Macnica-Galaxy/Document/Base board Schematic_C.pdf

# BASE BOARD_1

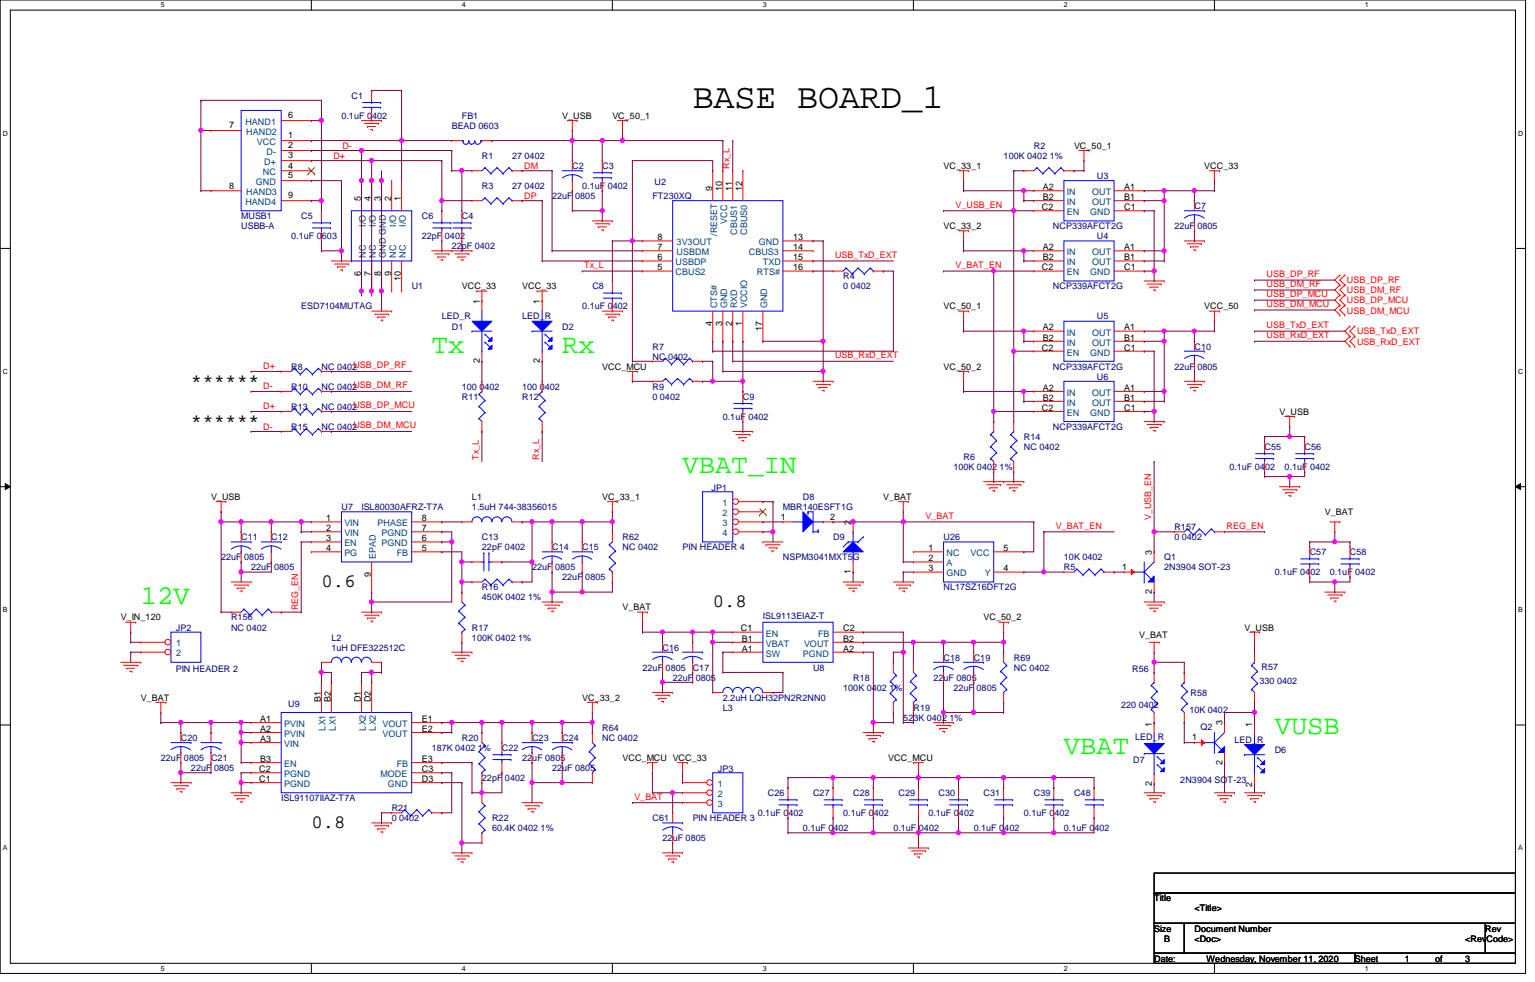
[picture p8: page 1]

# BASE BOARD_5

# SENSOR1

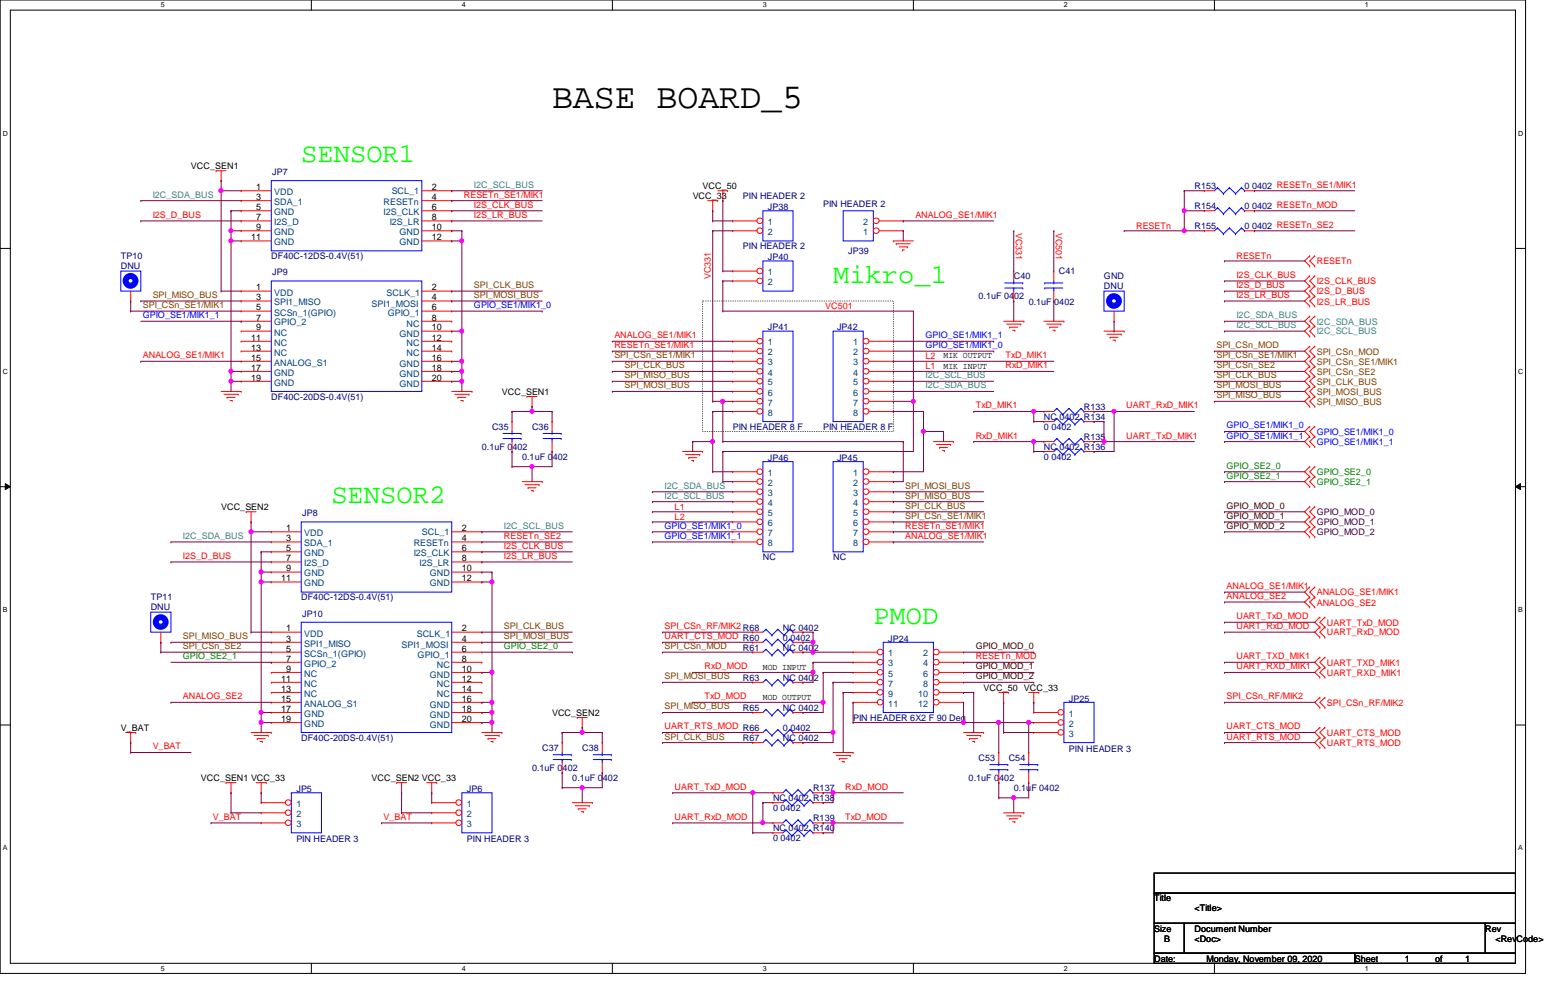
[picture p9: page 2]

# Mikro_2

# BASE BOARD_3

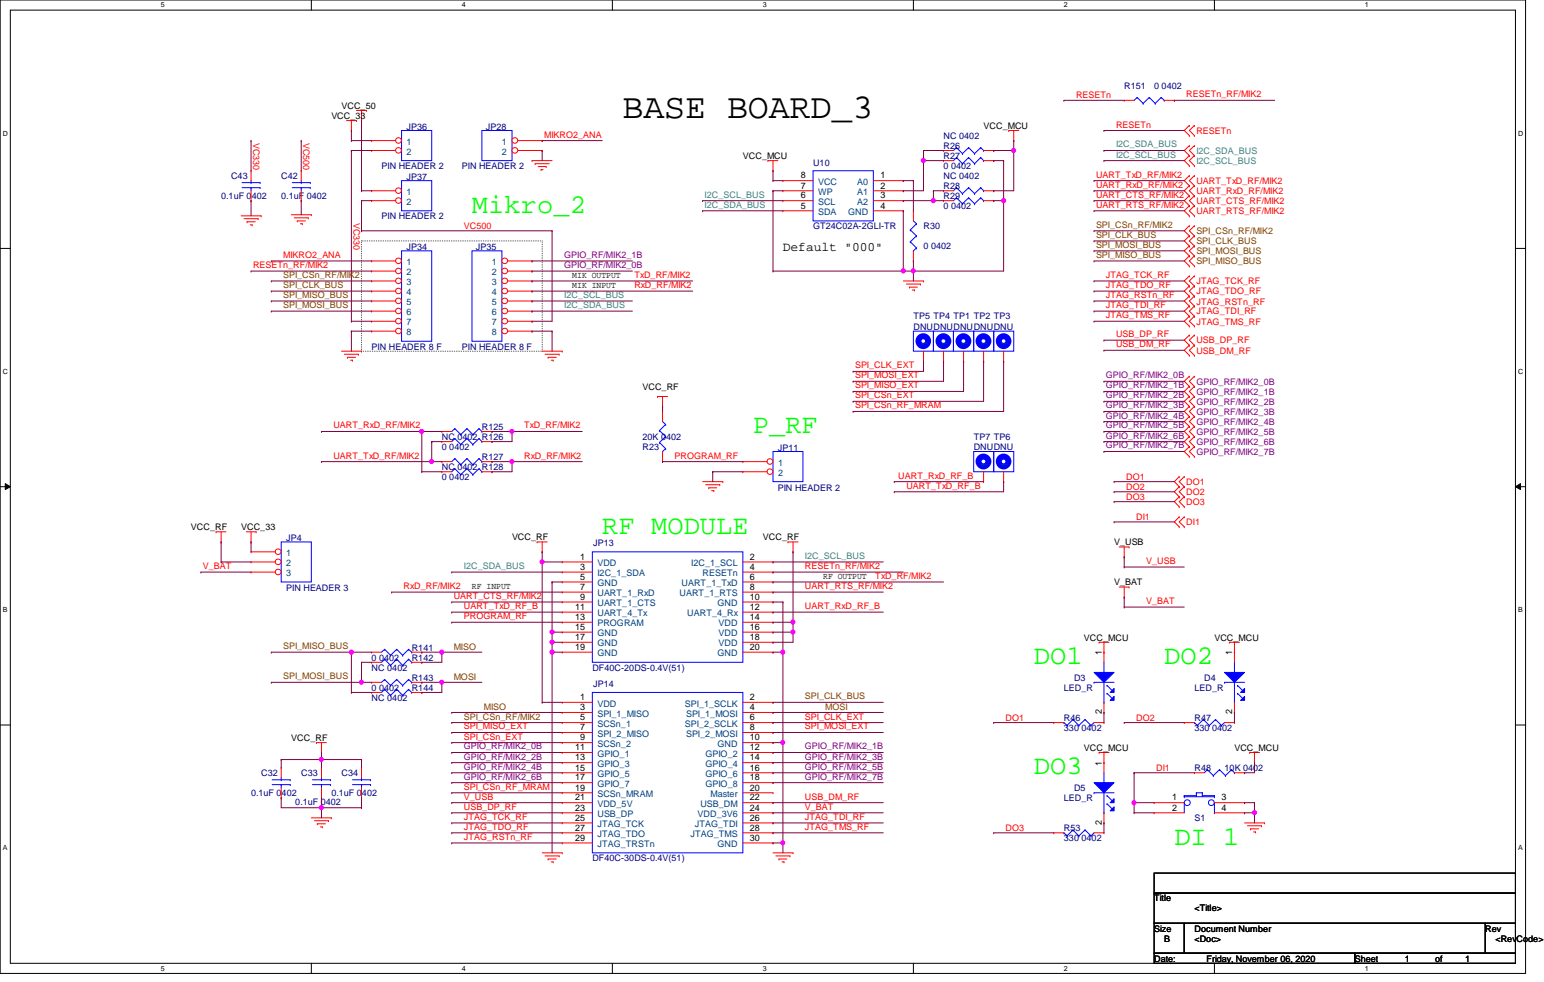
[picture p10: page 3]

GND 4 SDA 5 SCL 6 WP 7 VCC 8

# BASE BOARD_6

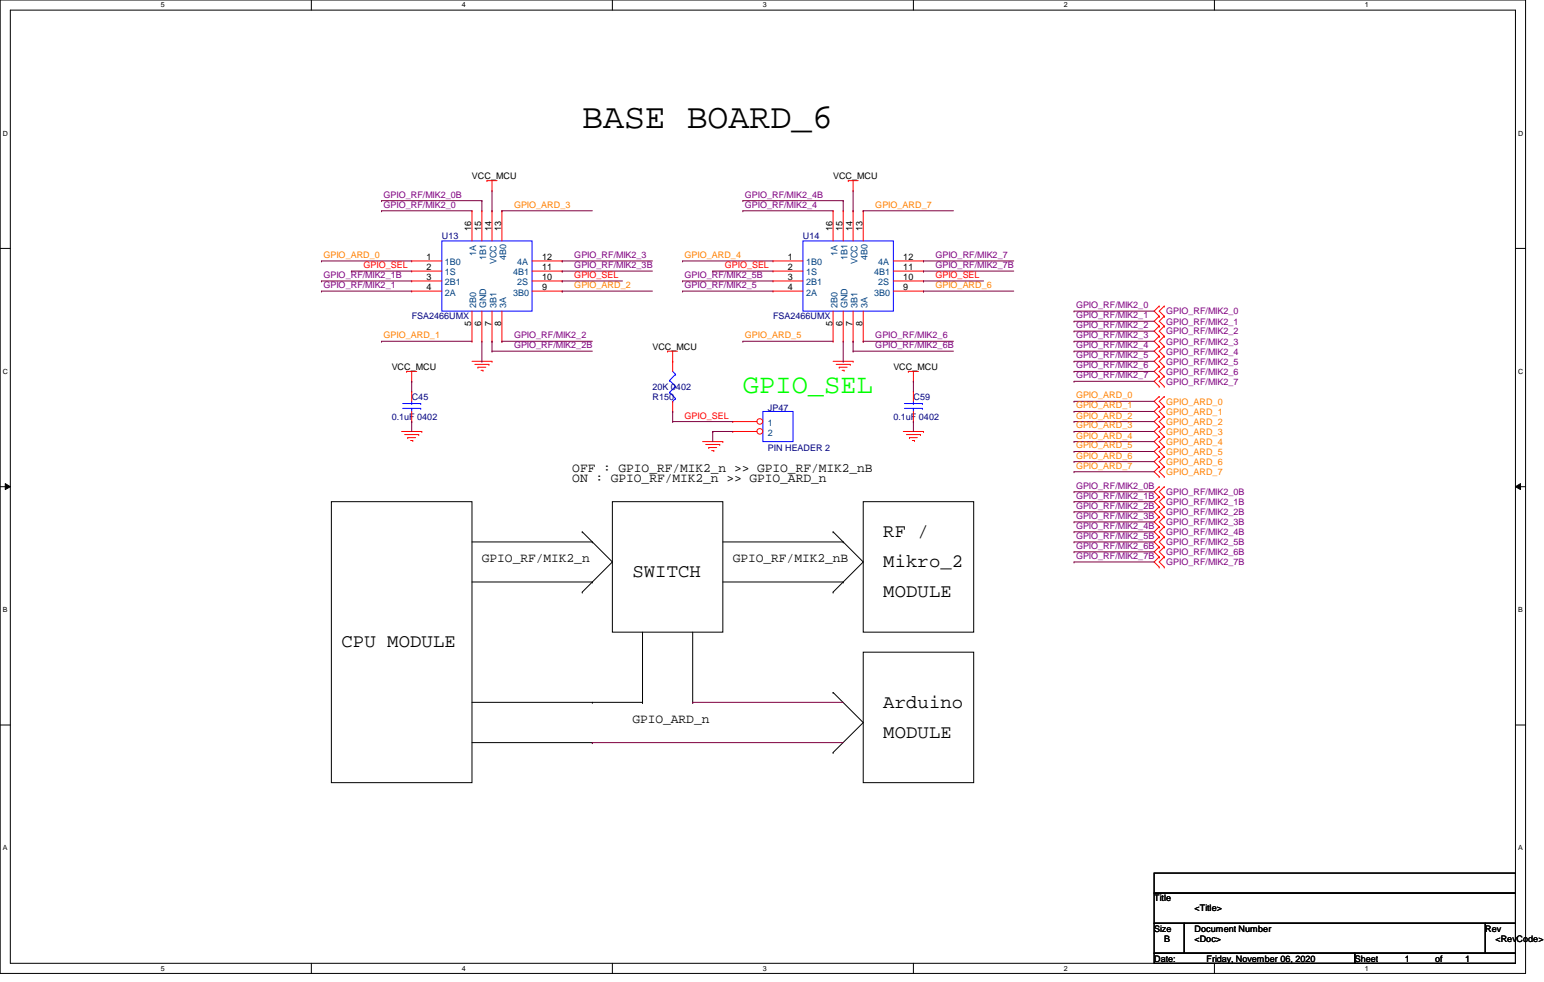
[picture p11: page 4]
CPU MODULE; SWITCH; GPIO_RF/MIK2_n; GPIO_ARD_n; GPIO_RF/MIK2_nB; Mikro_2; MODULE; Arduino MODULE; GPIO_SEL; OFF : GPIO_RF/MIK2_n >> GPIO_RF/MIK2_nB ON : GPIO_RF/MIK2_n >> GPIO_ARD_n; VCC_MCU; GPIO_RF/MIK2_0 GPIO_RF/MIK2_1 GPIO_RF/MIK2_2 GPIO_RF/MIK2_3 GPIO_RF/MIK2_4 GPIO_RF/MIK2_5 GPIO_RF/MIK2_6 GPIO_RF/MIK2_7; GPIO_ARD_0 GPIO_ARD_1 GPIO_ARD_2 GPIO_ARD_3 GPIO_ARD_4 GPIO_ARD_5 GPIO_ARD_6 GPIO_ARD_7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

# BASE BOARD_2

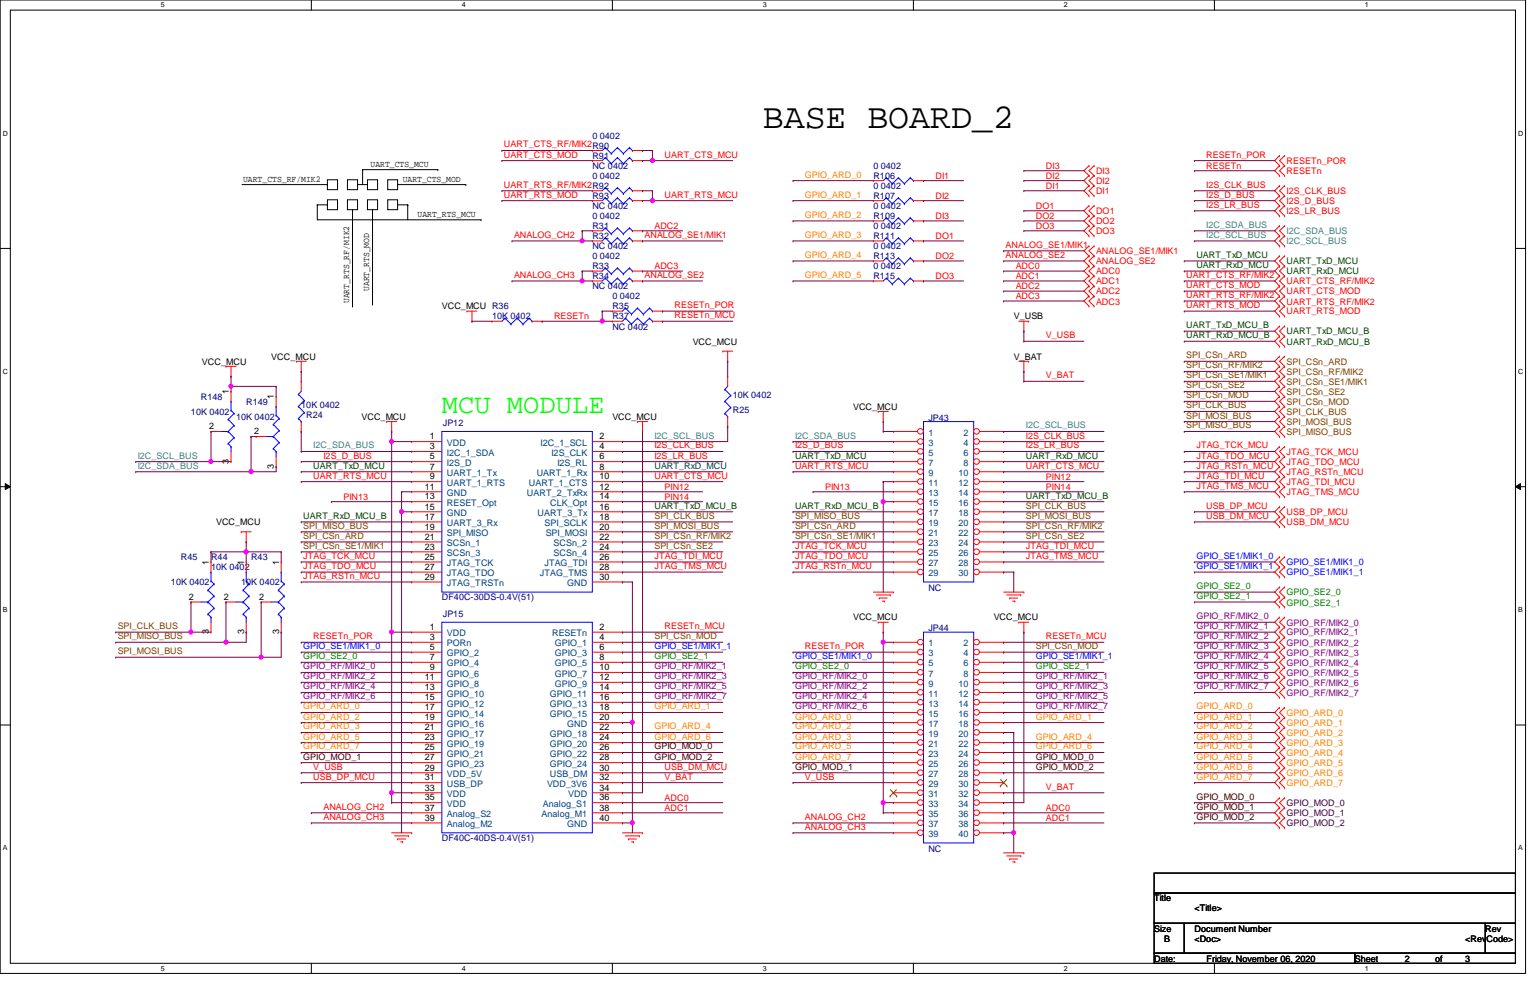
[picture p12: page 5]

# Arduino

# BASE BOARD_4

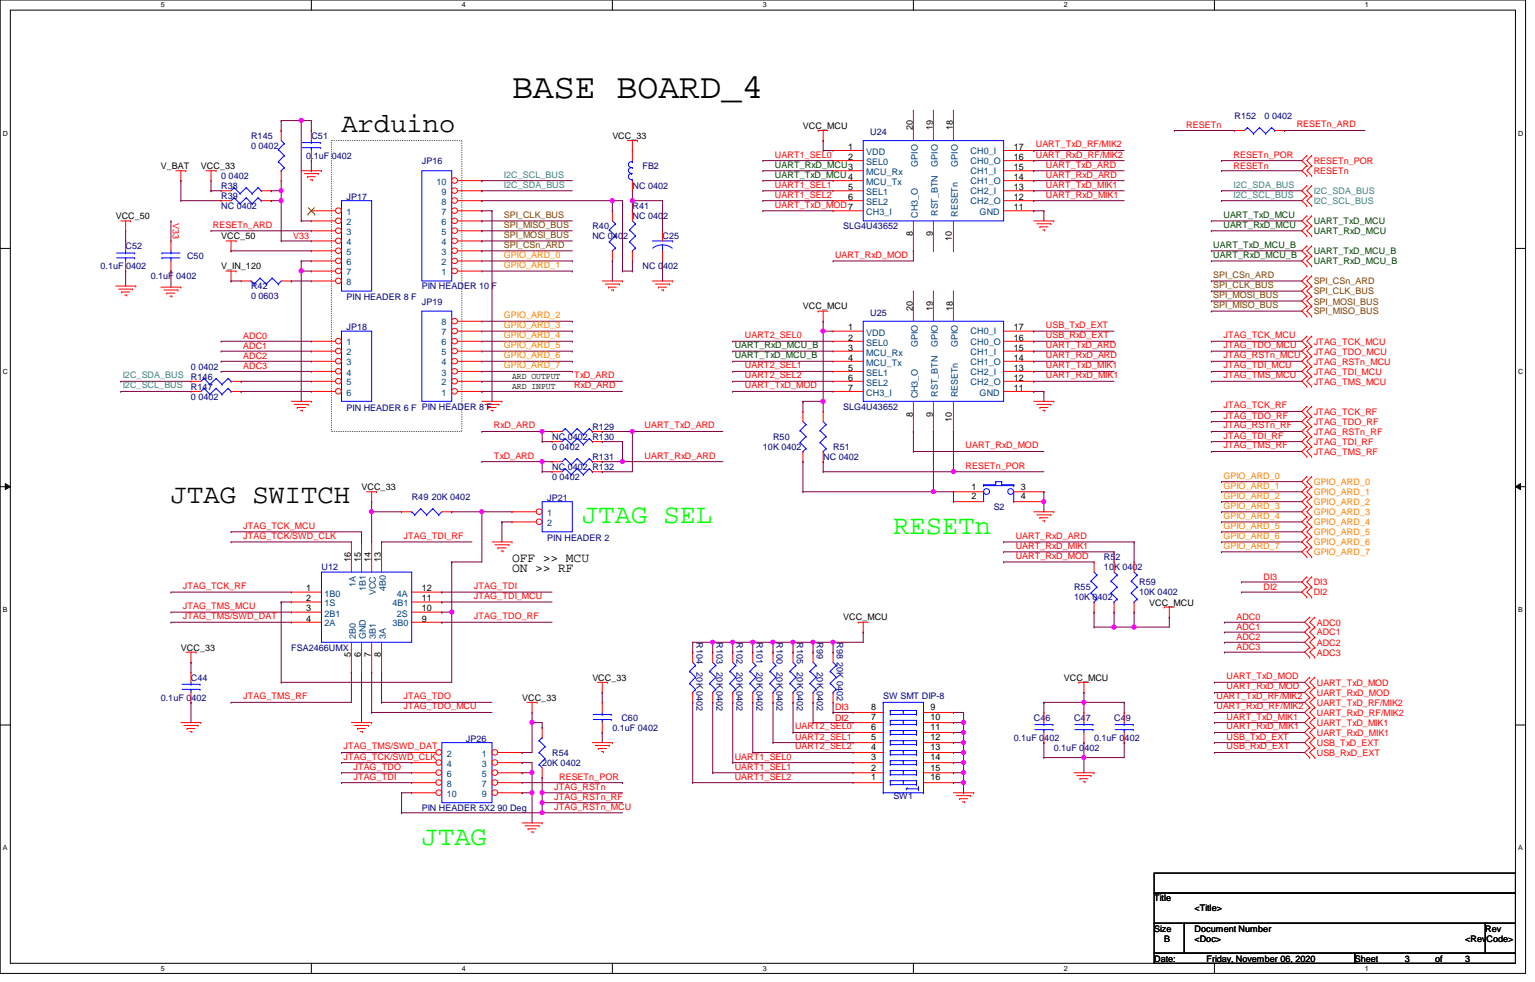
[picture p13: page 6]
