Macnica-Galaxy/Document/ON LV0104CS Sensor/49 ON LV0104CS Light Sensor.pdf

# ON Light Sensor

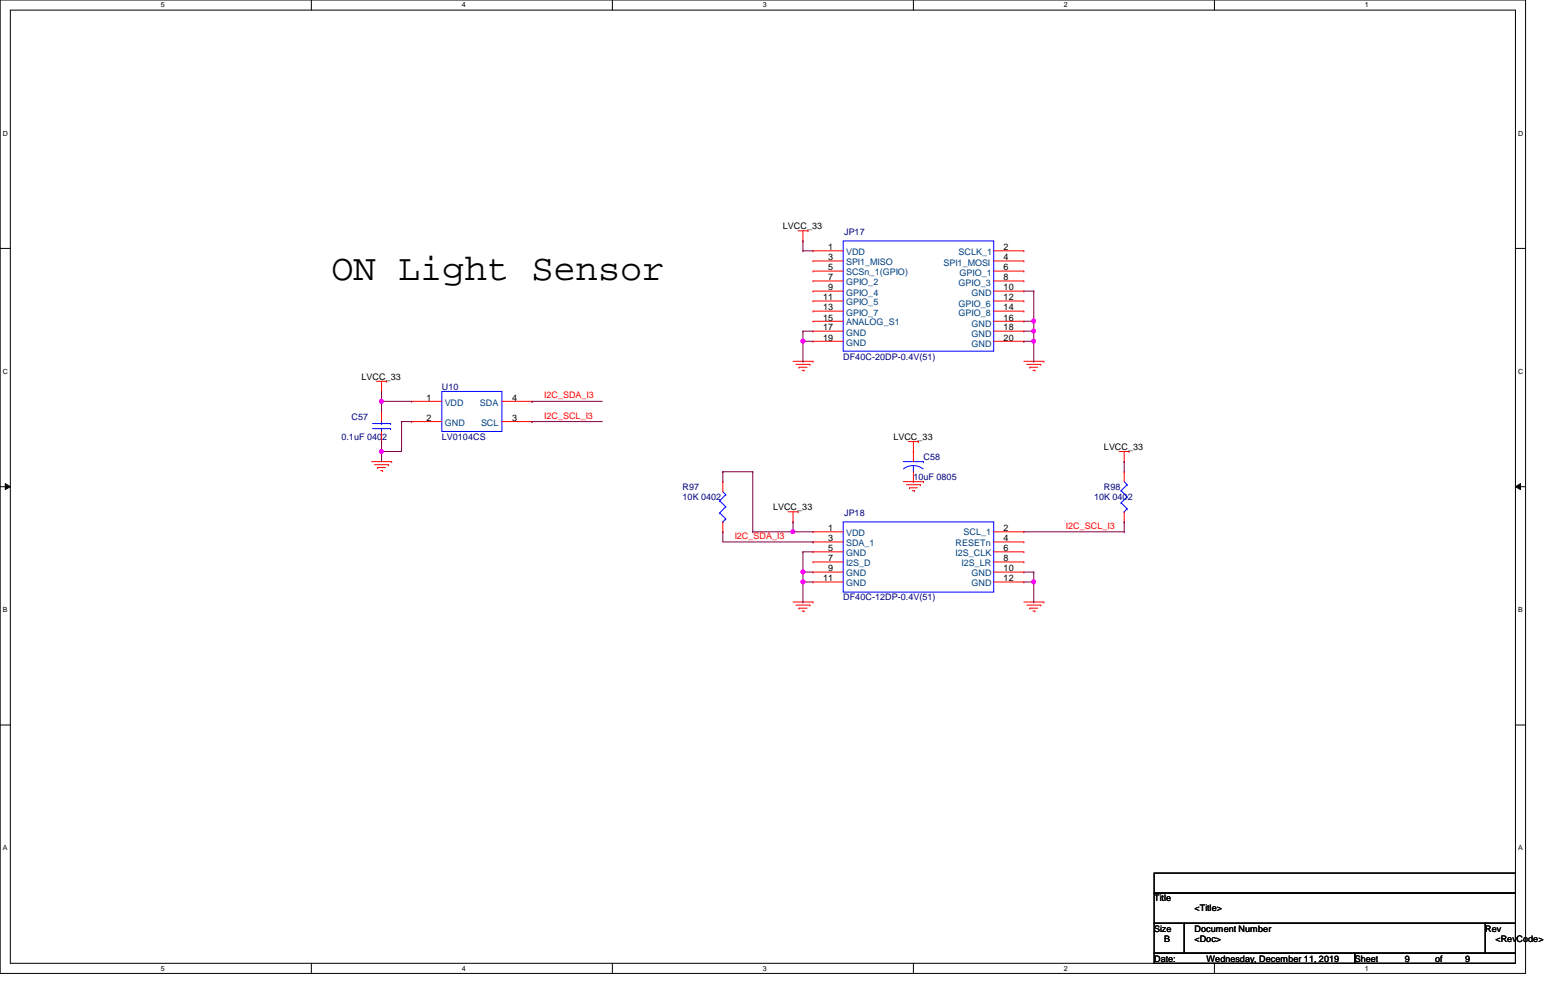
[picture p14: page 1]
LVCC_33; Title; Size; Document Number; Rev; Date:; Sheet; <Doc>; <RevCode>; <Title>; Wednesday, December 11, 2019; VDD 1; GND 2; SCL; SDA; RESETn; GND 5; I2S_CLK 6; GND 9; GND 10; GND 11; GND 12; SDA_1 3; SCL_1 2 VDD 1; SCSn_1(GPIO) 5; ANALOG_S1 15 GND 17; GND 19; GND 20; SCLK_1 2; SPI1_MISO 3; GPIO_7 13; SPI1_MOSI; GPIO_4 9; GPIO_3; 8 GPIO_2 7; GPIO_1 6; GPIO_6; 12 GPIO_5 11; GPIO_8; GND 16 GND 18; I2C_SCL_I3; I2C_SDA_I3
