Macnica-Galaxy/Document/Infineon DPS365 Sensor/43 Infineon Pressure Tempture.pdf

# Infineon Pressure & Tempture Sensor

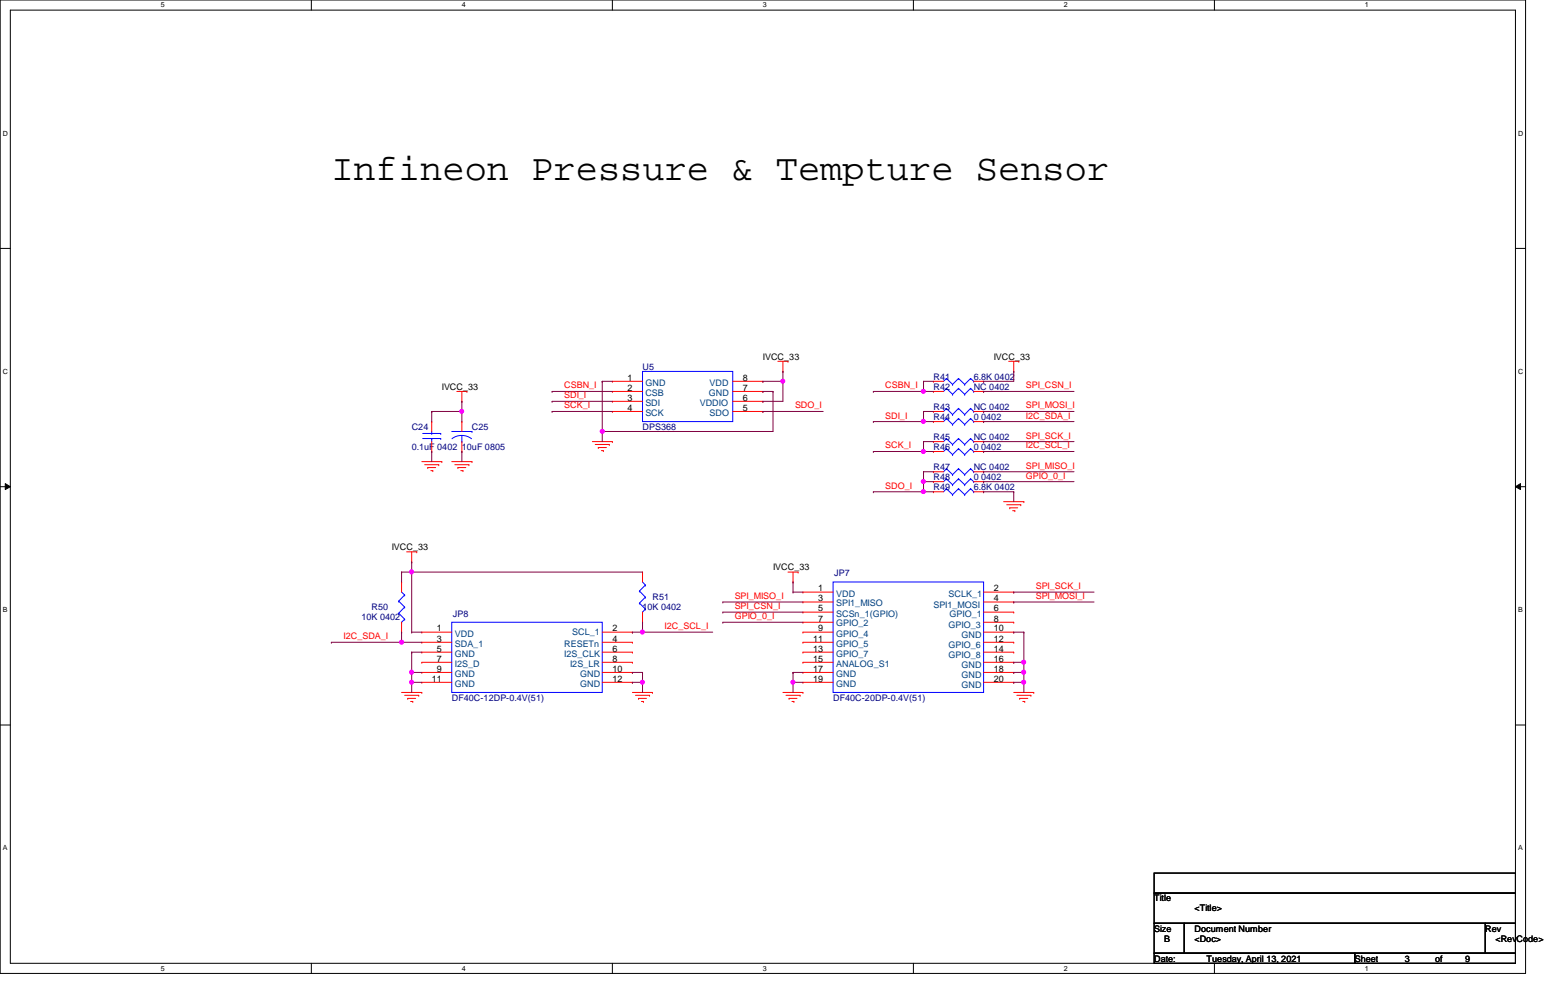
[picture p15: page 1]
