Macnica-Galaxy/Document/IDT HS3001 Sensor/31 IDT_HS300x_SENSOR.pdf

# IDT Humidity and Temperature Sensor

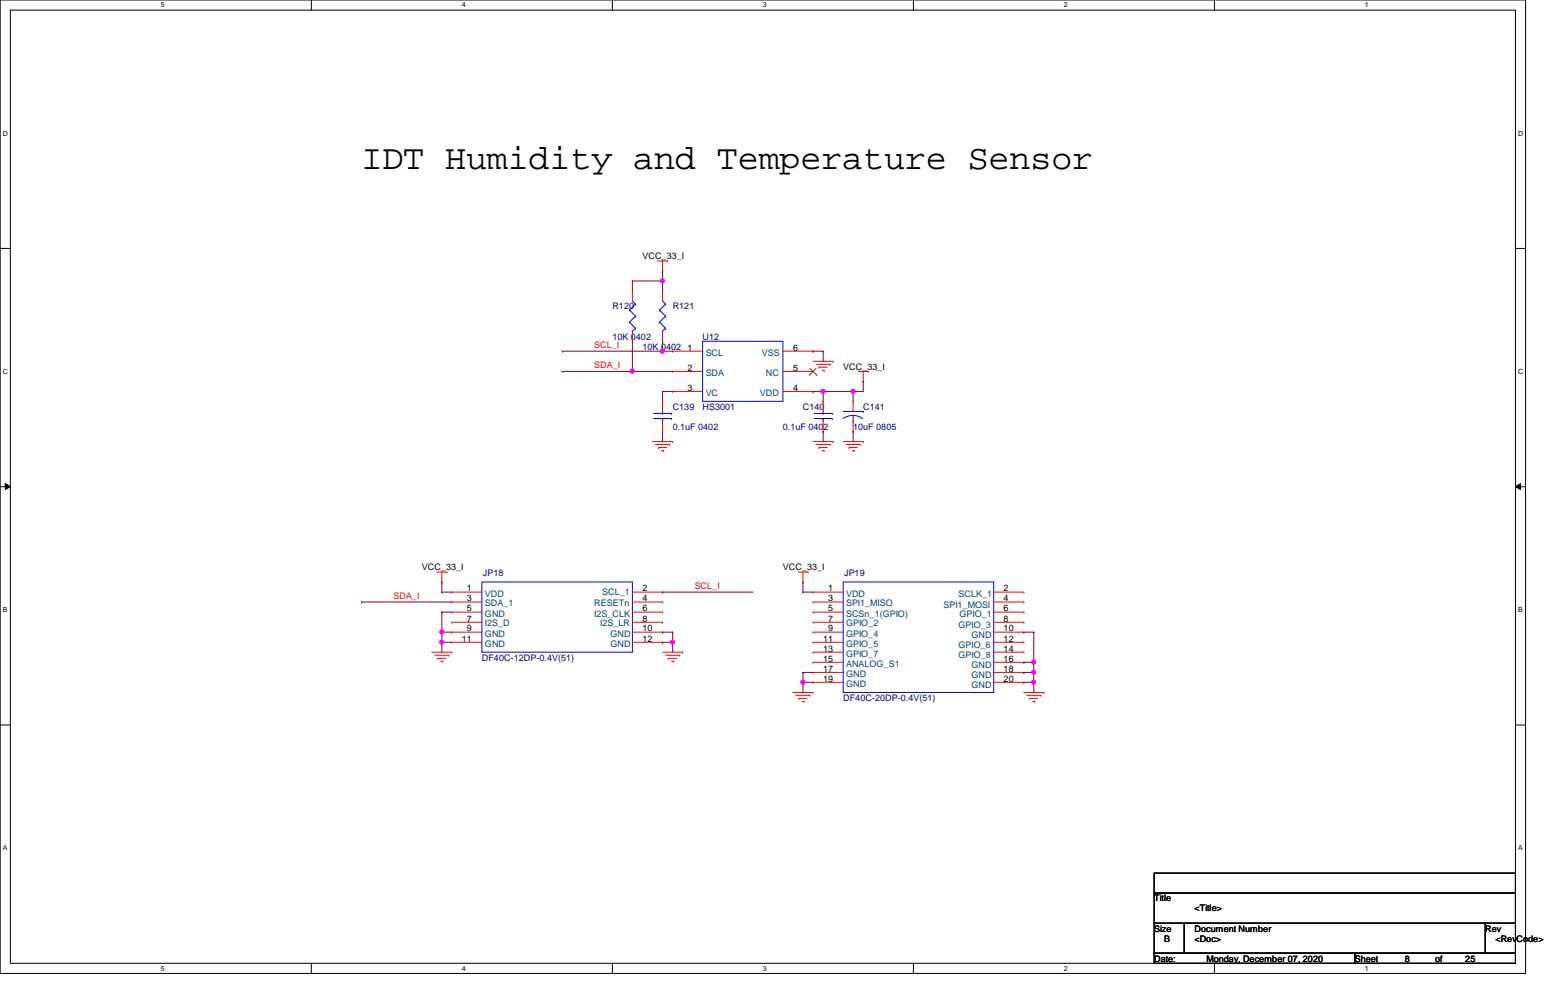
[picture p16: page 1]
