Macnica-Galaxy/Document/IDT ZMOD4401 Sensor/32 IDT_ZMOD4410_SENSOR.pdf

# IDT Gas Sensor

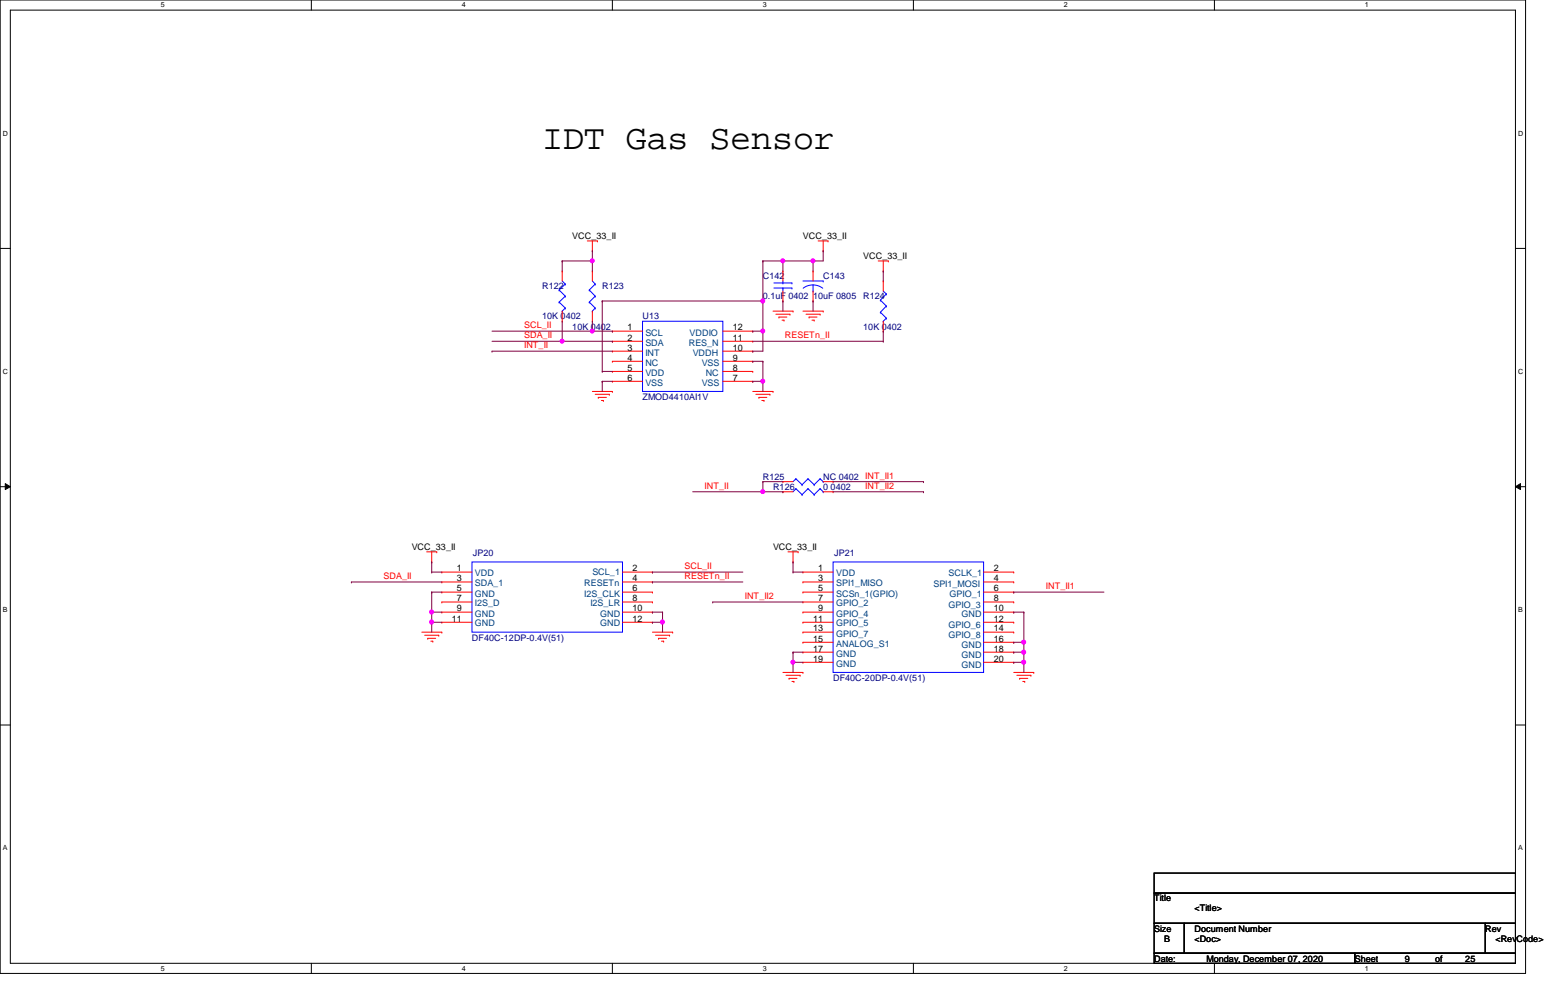
[picture p17: page 1]
