Macnica-Galaxy/Document/Microchip WIFI 1510 RF/26 Microchip_WIFI_1510.pdf

# MICROCHIP WIFI

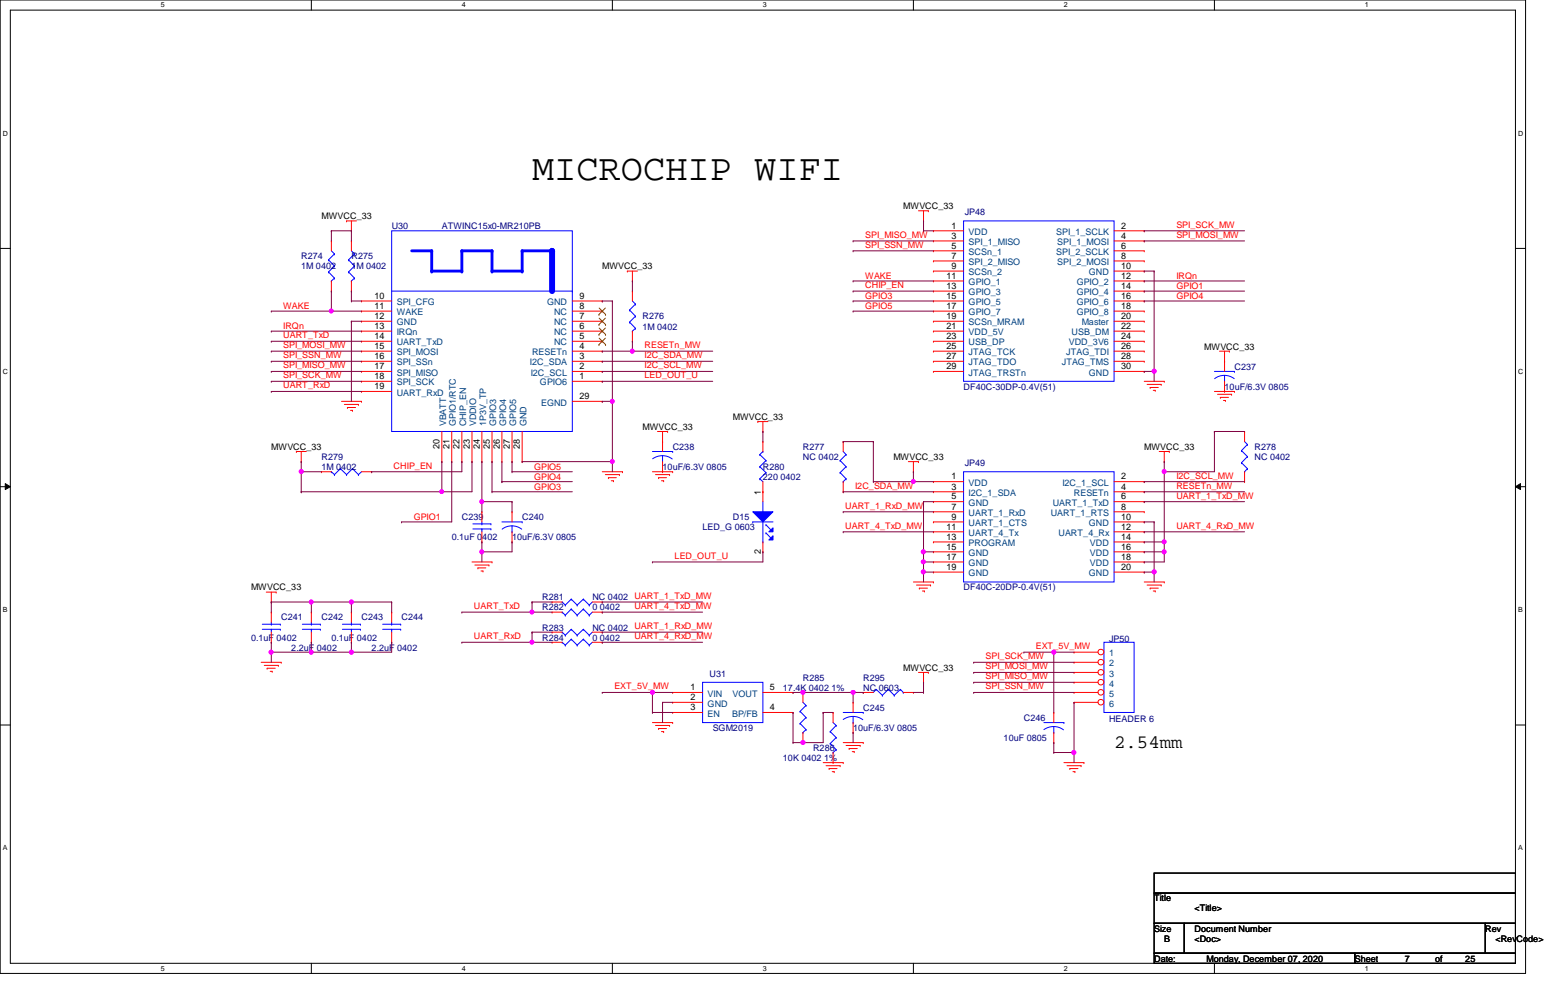
[picture p18: page 1]

GPIO6 1 I2C_SCL 2 I2C_SDA 3 RESETn 4 NC 5 NC 6 NC 7 NC 8 GND 9 SPI_CFG 10 WAKE 11 GND 12 IRQn 13 UART_TxD 14 SPI_MOSI 15 SPI_SSn 16 SPI_MISO 17 SPI_SCK 18
