Macnica-Galaxy/Document/ON NCT375 Sensor/33 ON_NCT375_SENSOR.pdf

# ON Semi Temperature Sensor

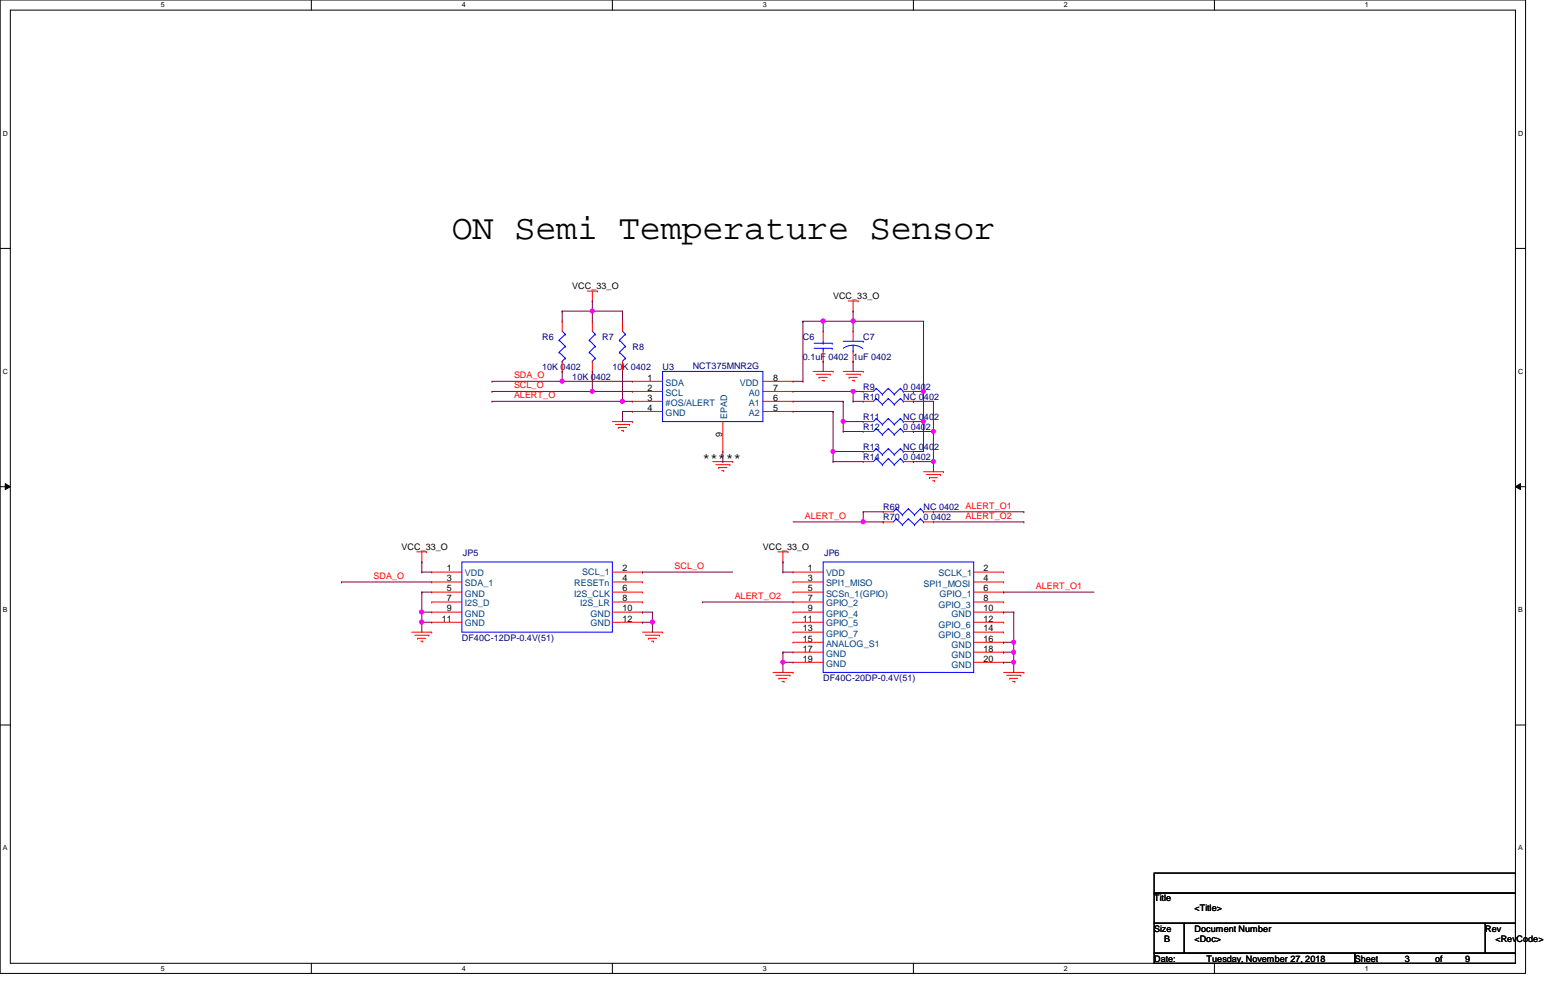
[picture p19: page 1]
