Macnica-Galaxy/Document/Renesas ISL29023 Sensor/49 Renesas ISL29023_SENSOR.pdf

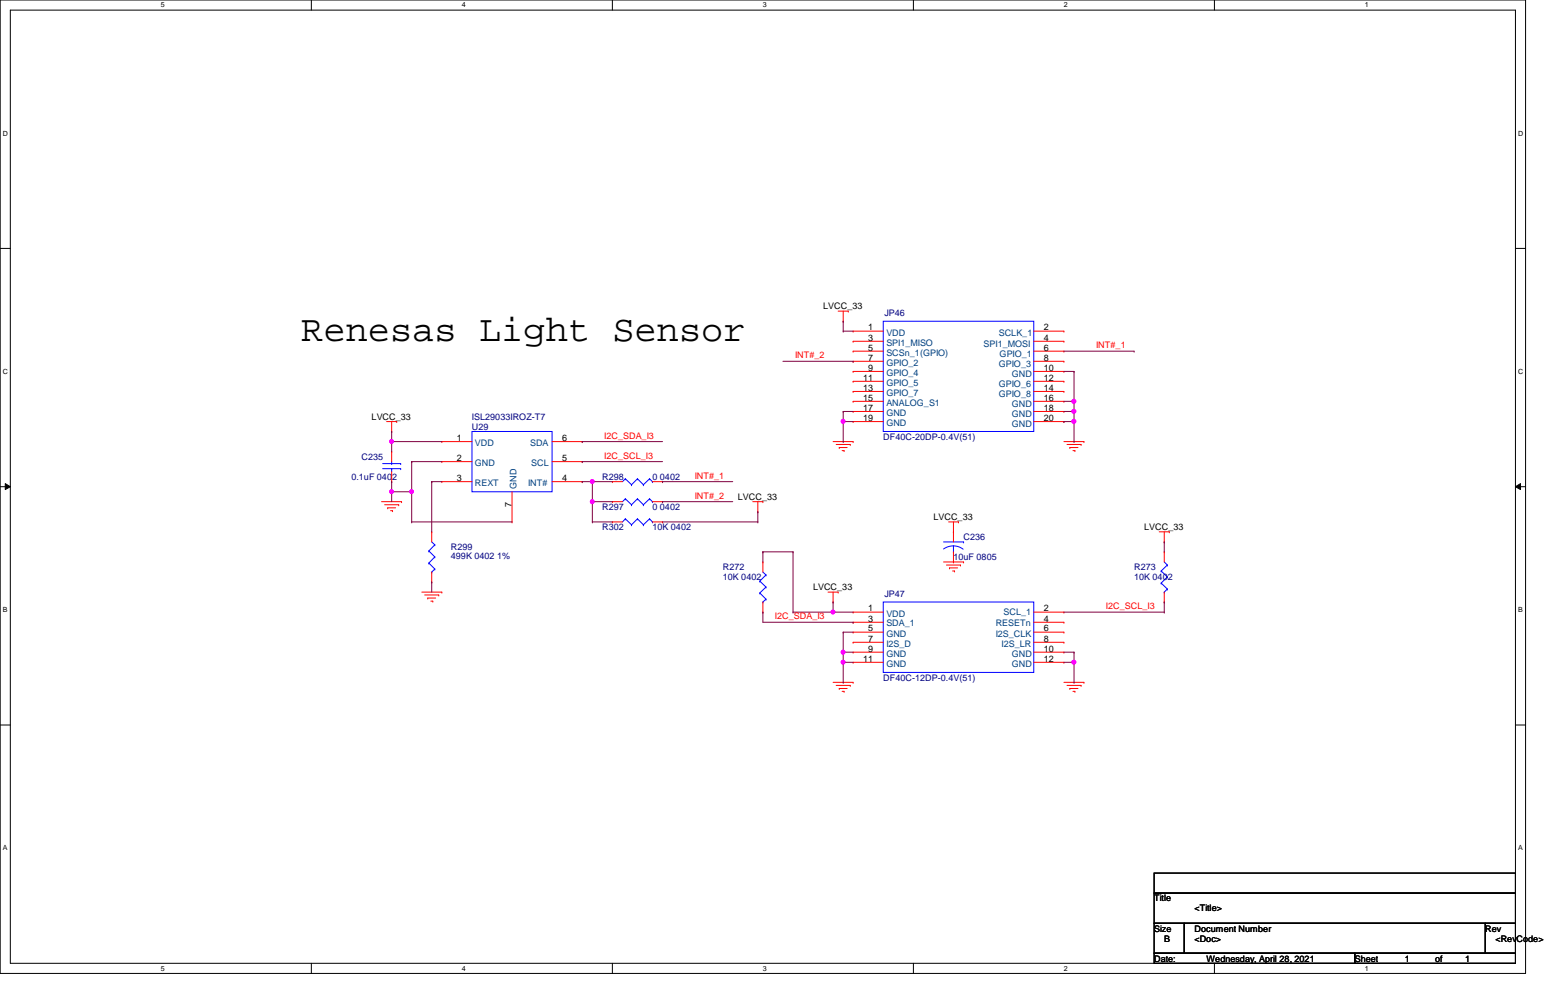
[picture p20: page 1]
