Macnica-Galaxy/Document/Microchip SAML21G18B MCU/21 Microchip_SAM21G18.pdf

## OUTPUT

# MICROCHIP

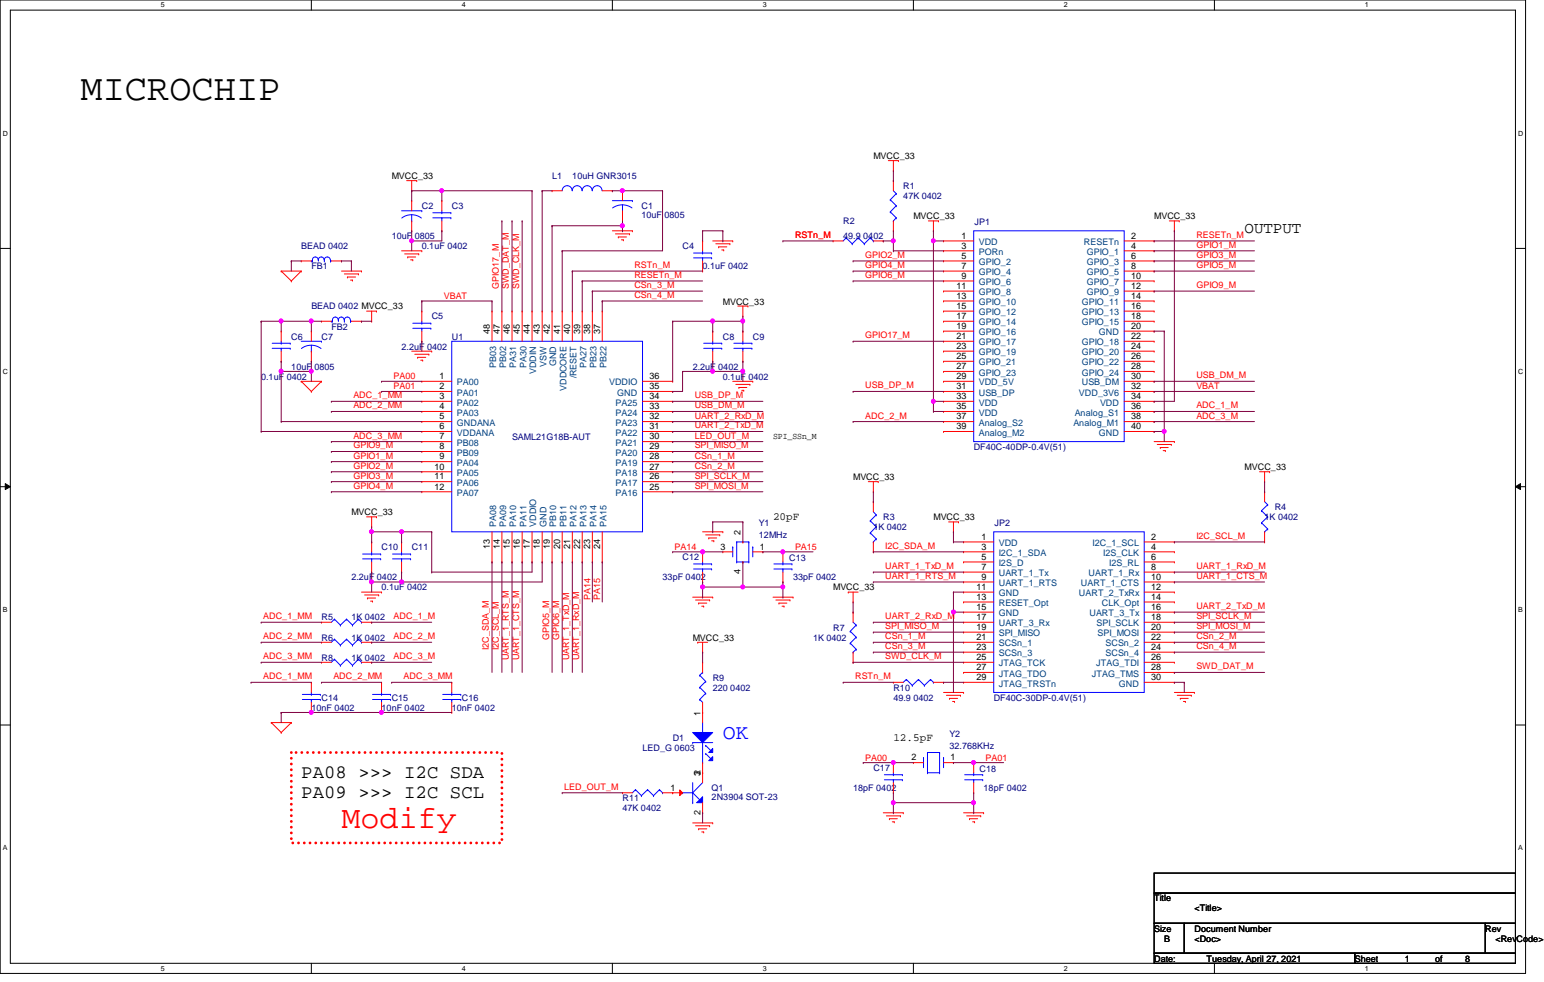
[picture p21: page 1]
