Macnica-Galaxy/Document/USI BM22 RF/41 USI_BM22_RF.pdf

# USI_BM22

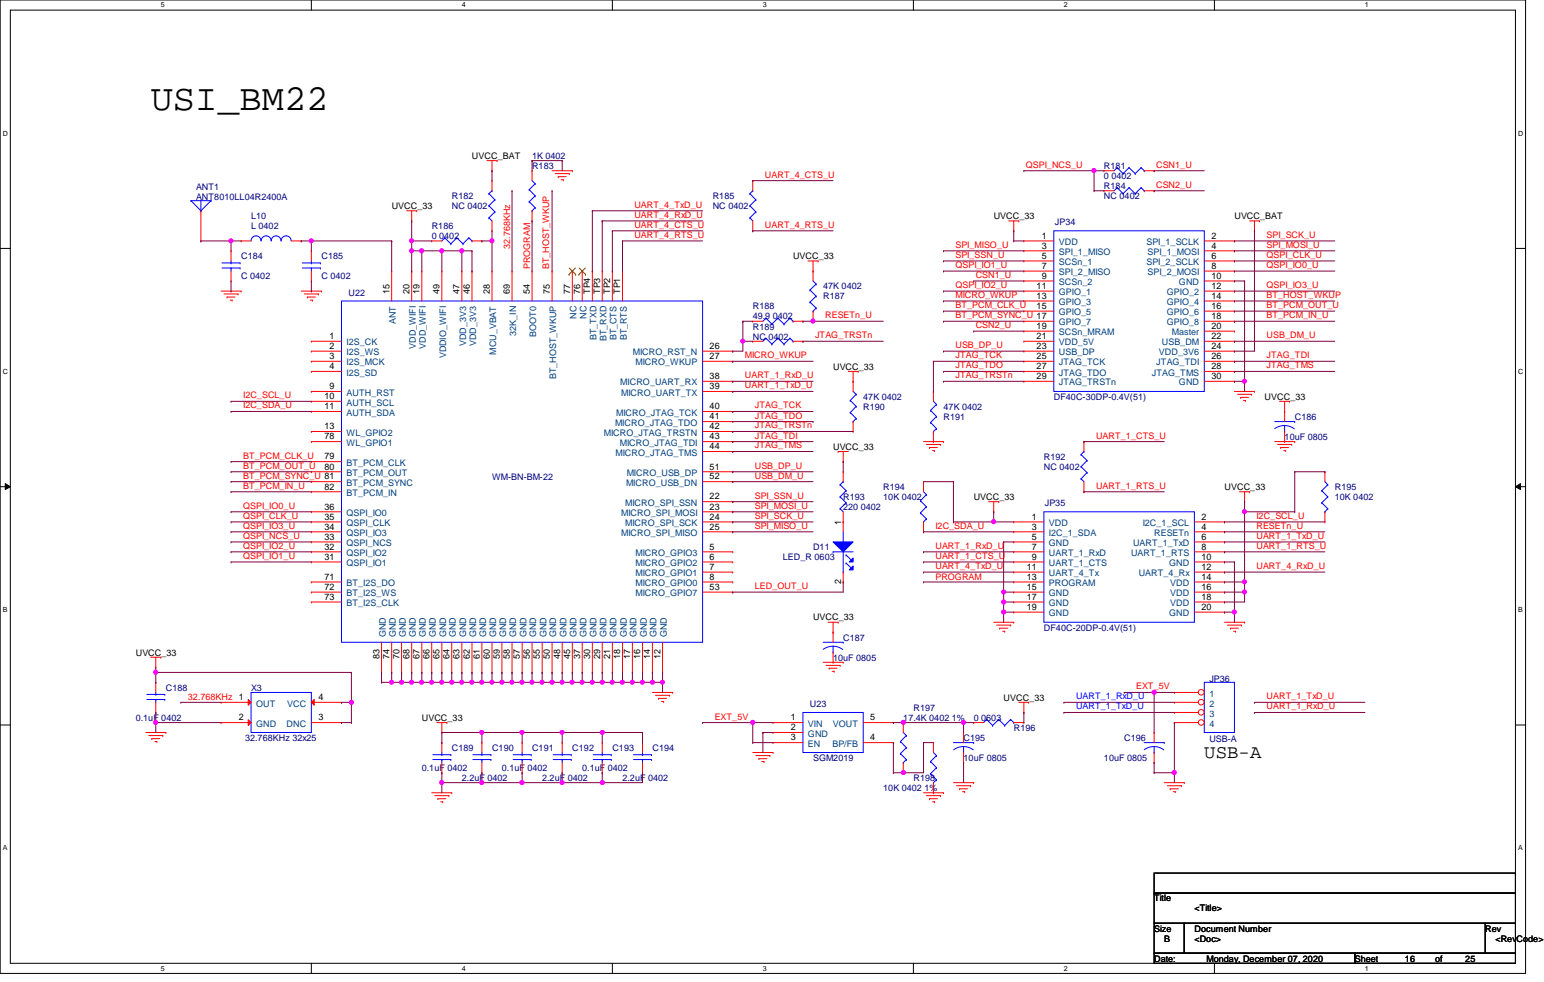
[picture p22: page 1]
