Macnica-Galaxy/Document/ADI ADXL362 Sensor/53 ADI ADXL362_SENSOR.pdf

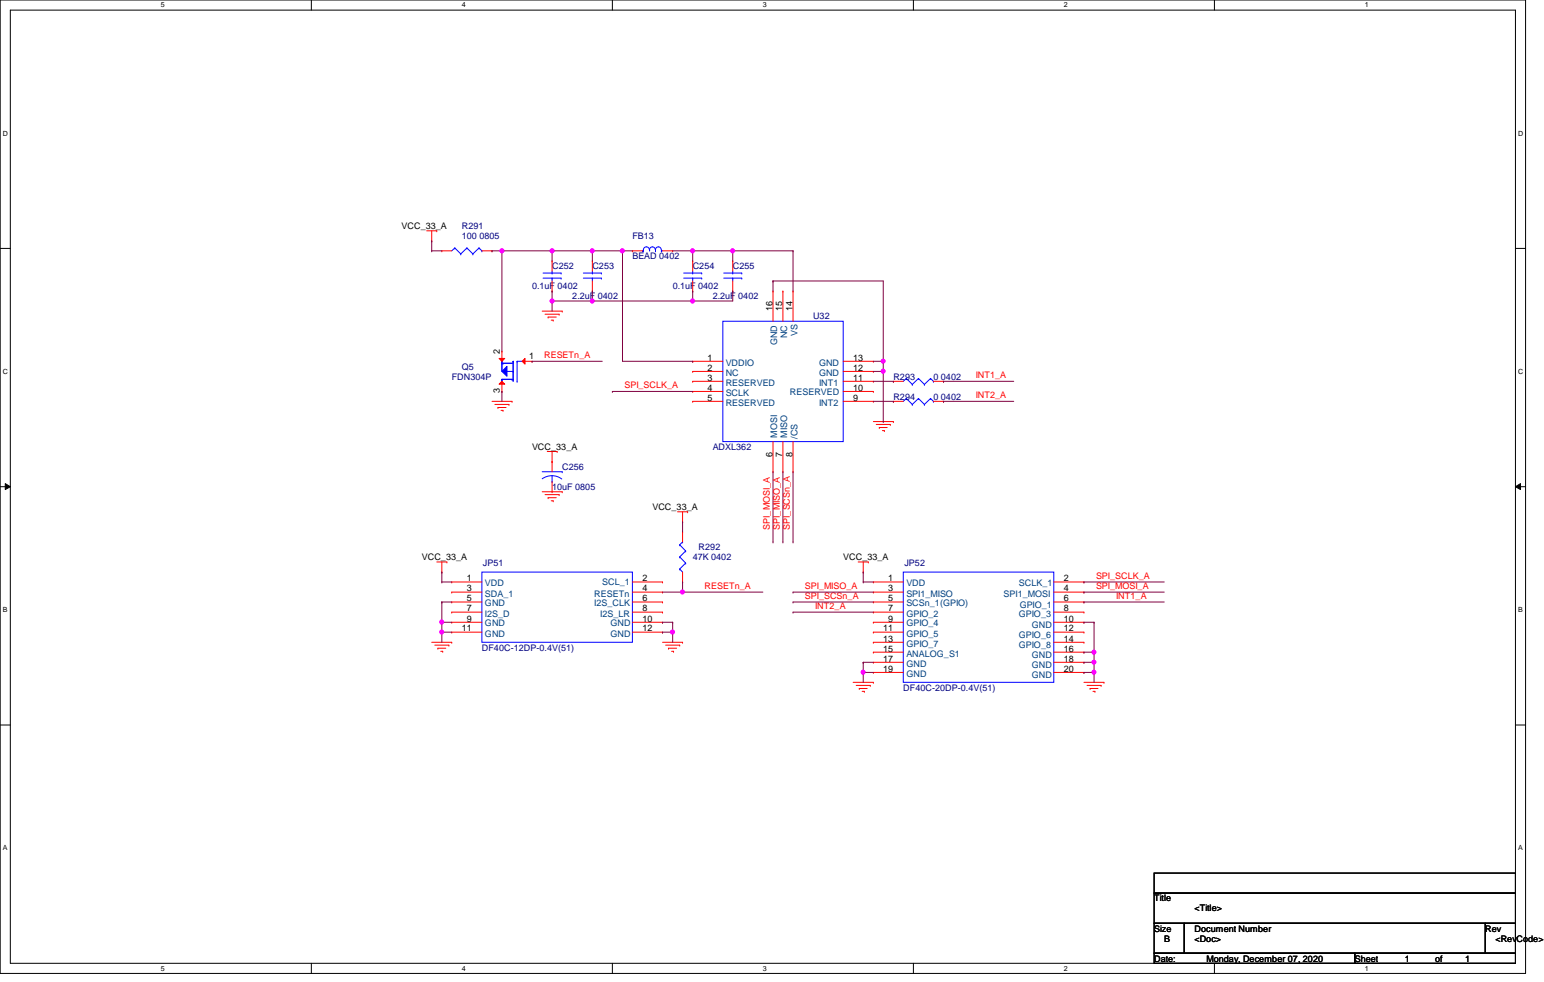
[picture p23: page 1]
