Macnica-Galaxy/Document/Cypress PSOC6 MCU/23 Cypress_BLE_MCU.pdf

*****

***** | *****

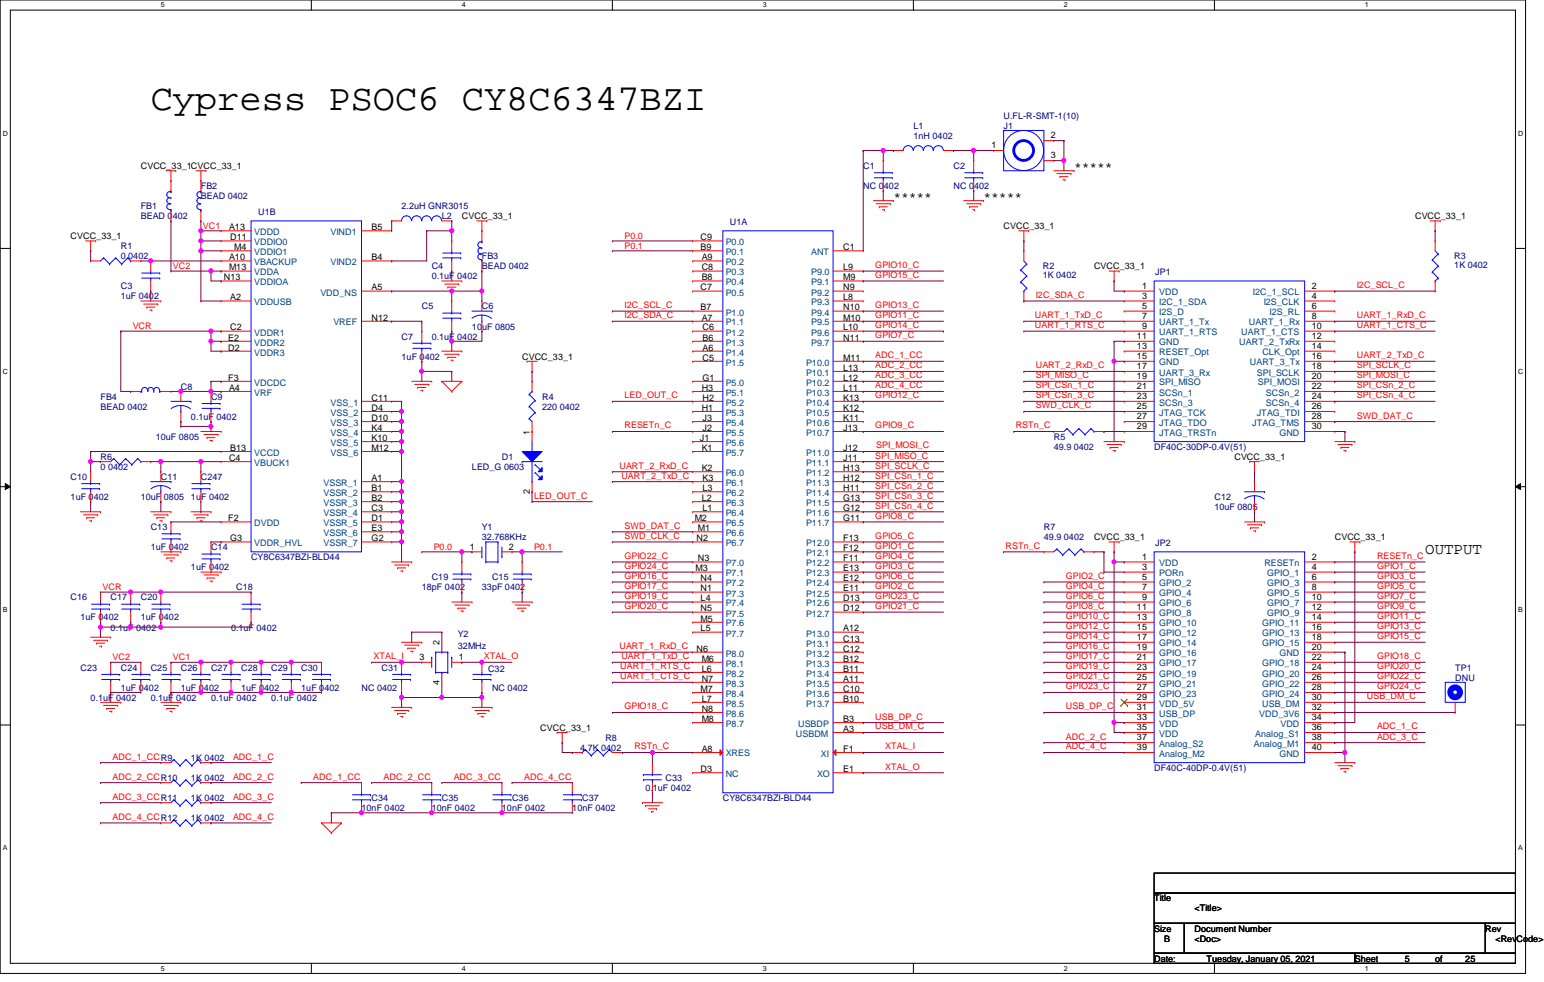
[picture p24: page 1]
