Macnica-Galaxy/Document/Dialog DA14531 RF/52 Dialog DA14531M.pdf

# Dialog DA14531MOD

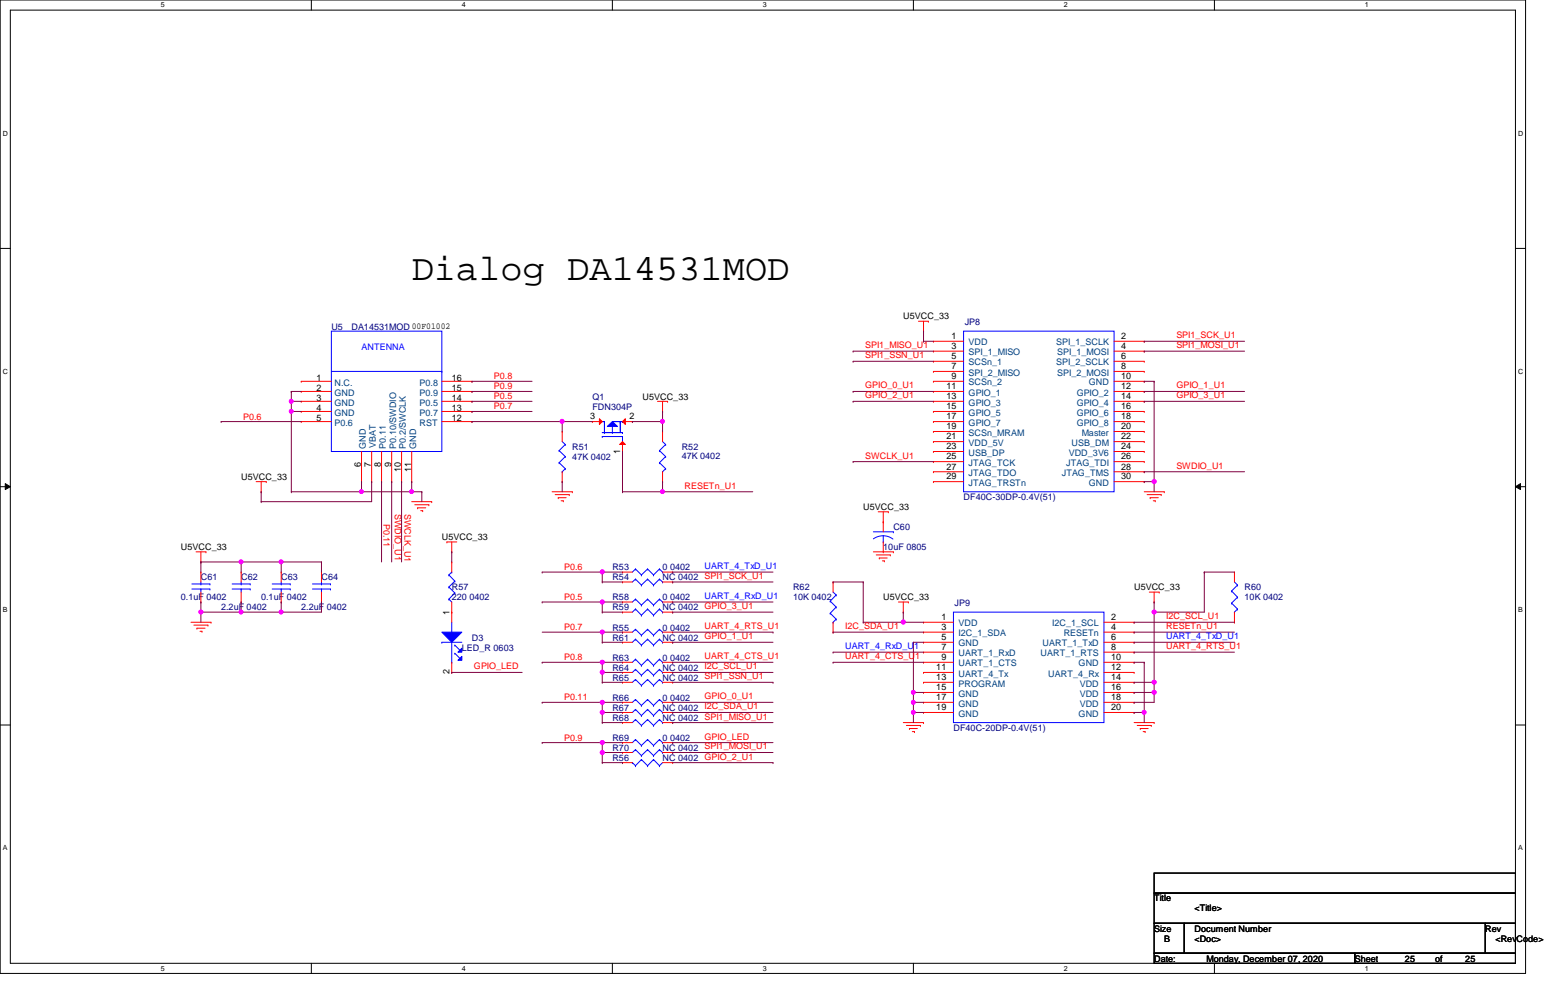
[picture p25: page 1]
