Macnica-Galaxy/Document/Dialog DA16200 RF/51 Dialog DA16200M.pdf

# Dialog DA16200MOD

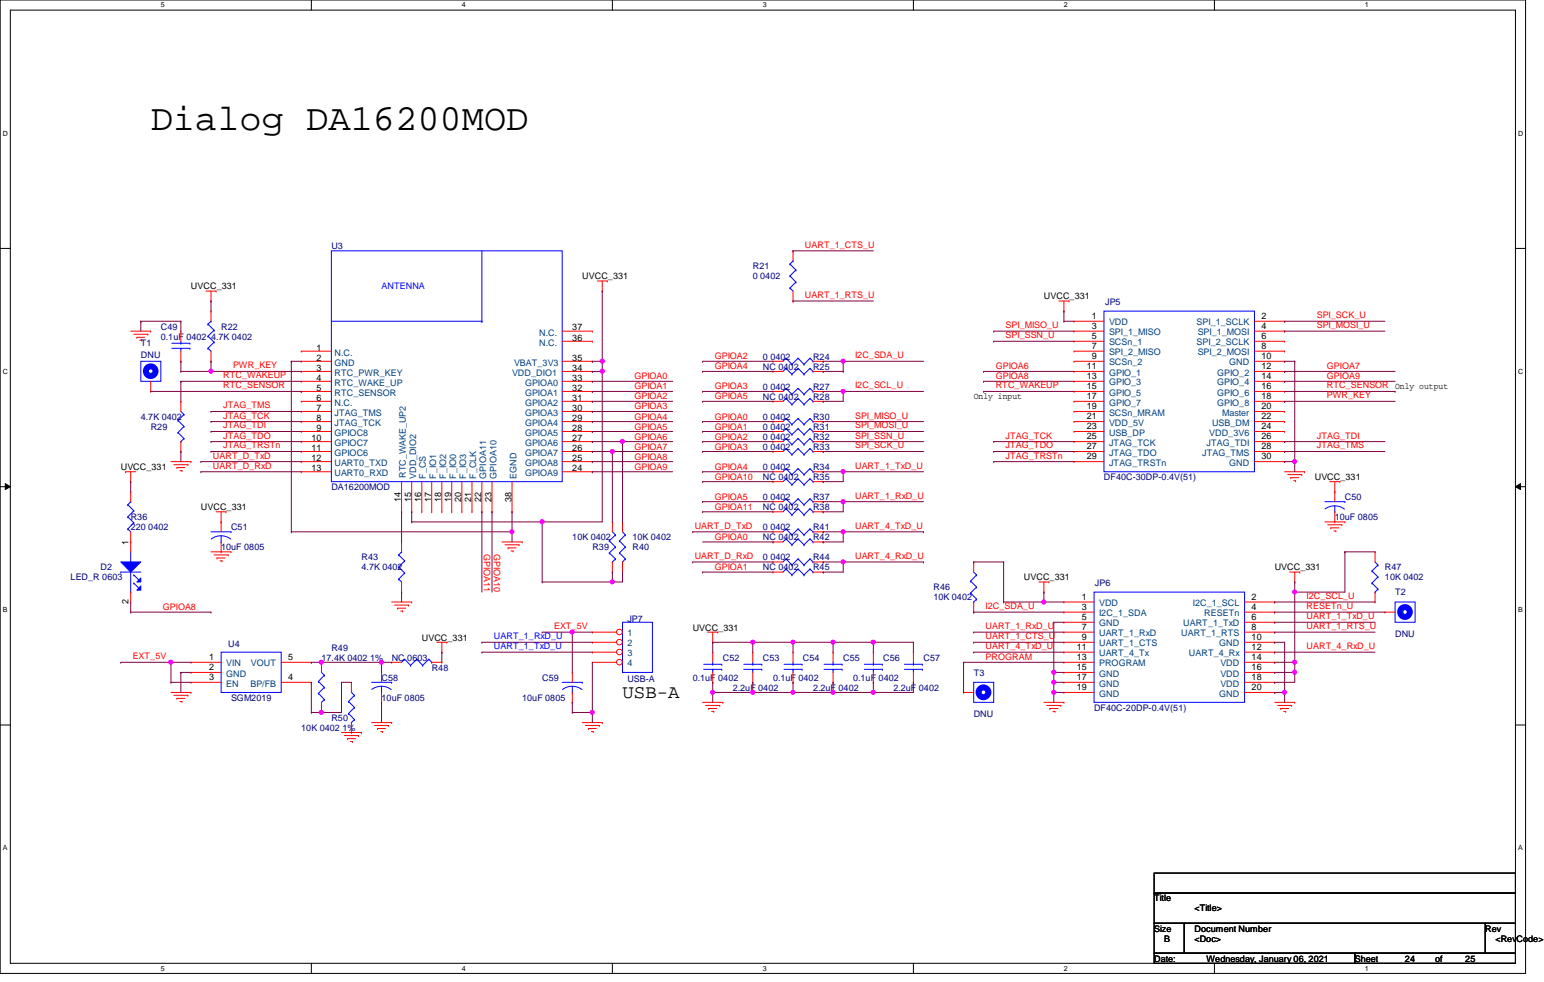
[picture p26: page 1]
