Macnica-Galaxy/Document/Renesas RA MCU/50 Renesas_RA2A1_MCU.pdf

# Renesas MCU-RA

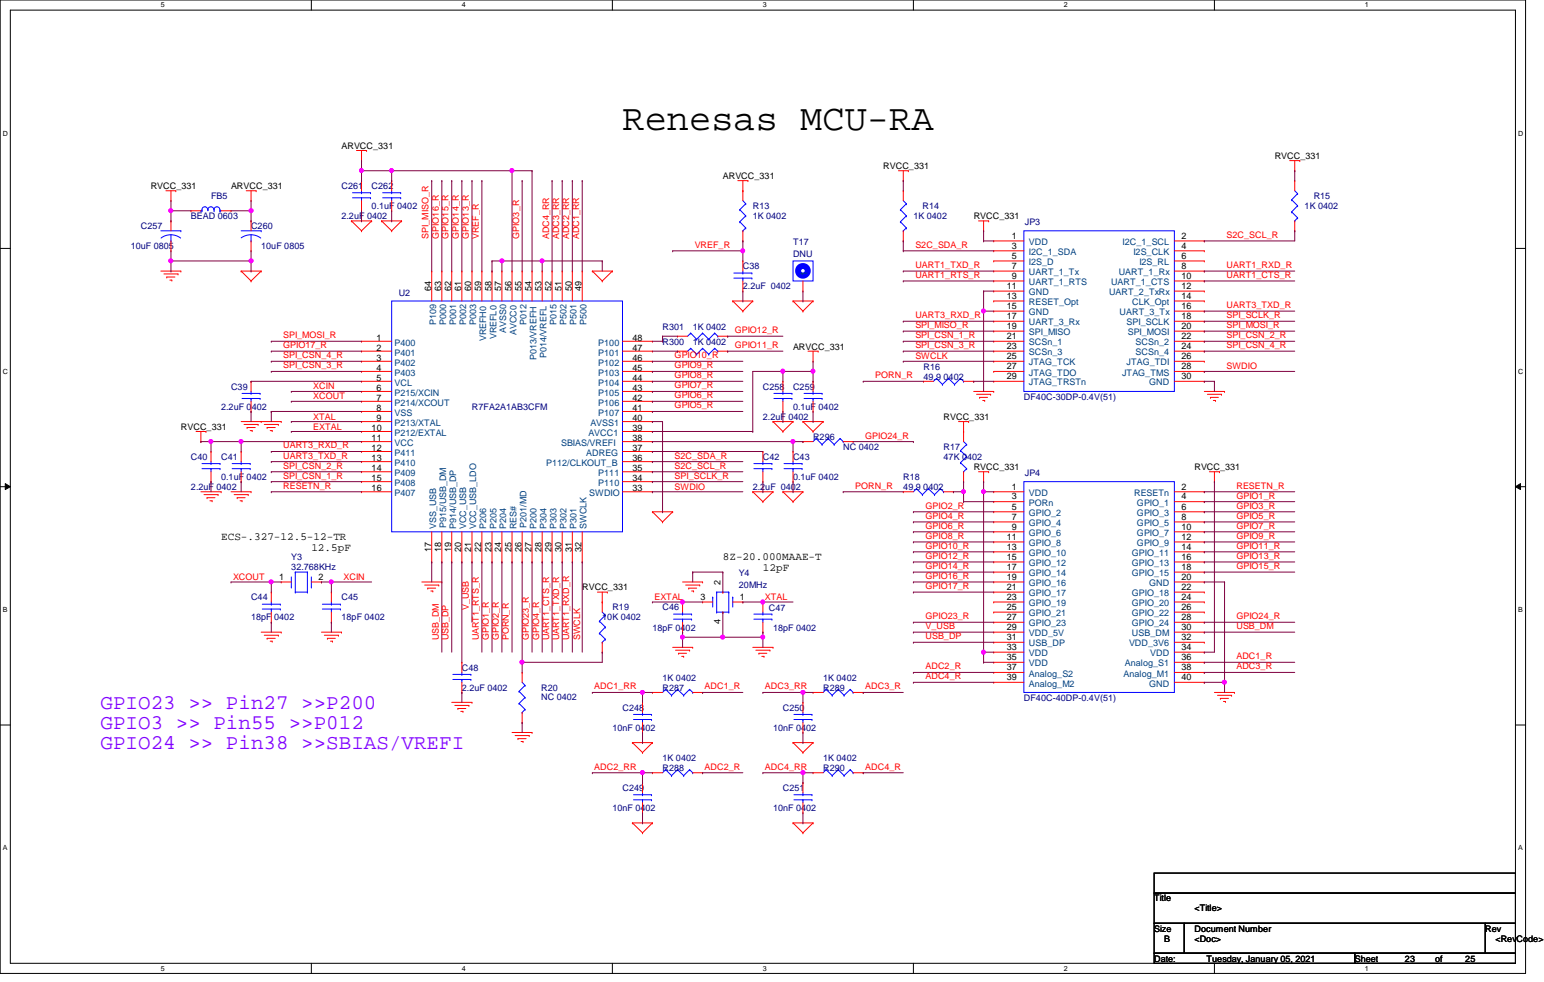
[picture p27: page 1]
