Macnica-Galaxy/Document/Renesas RX MCU/47 Renesas RX MCU.pdf

# Renesas MCU-RX_1

## OUTPUT

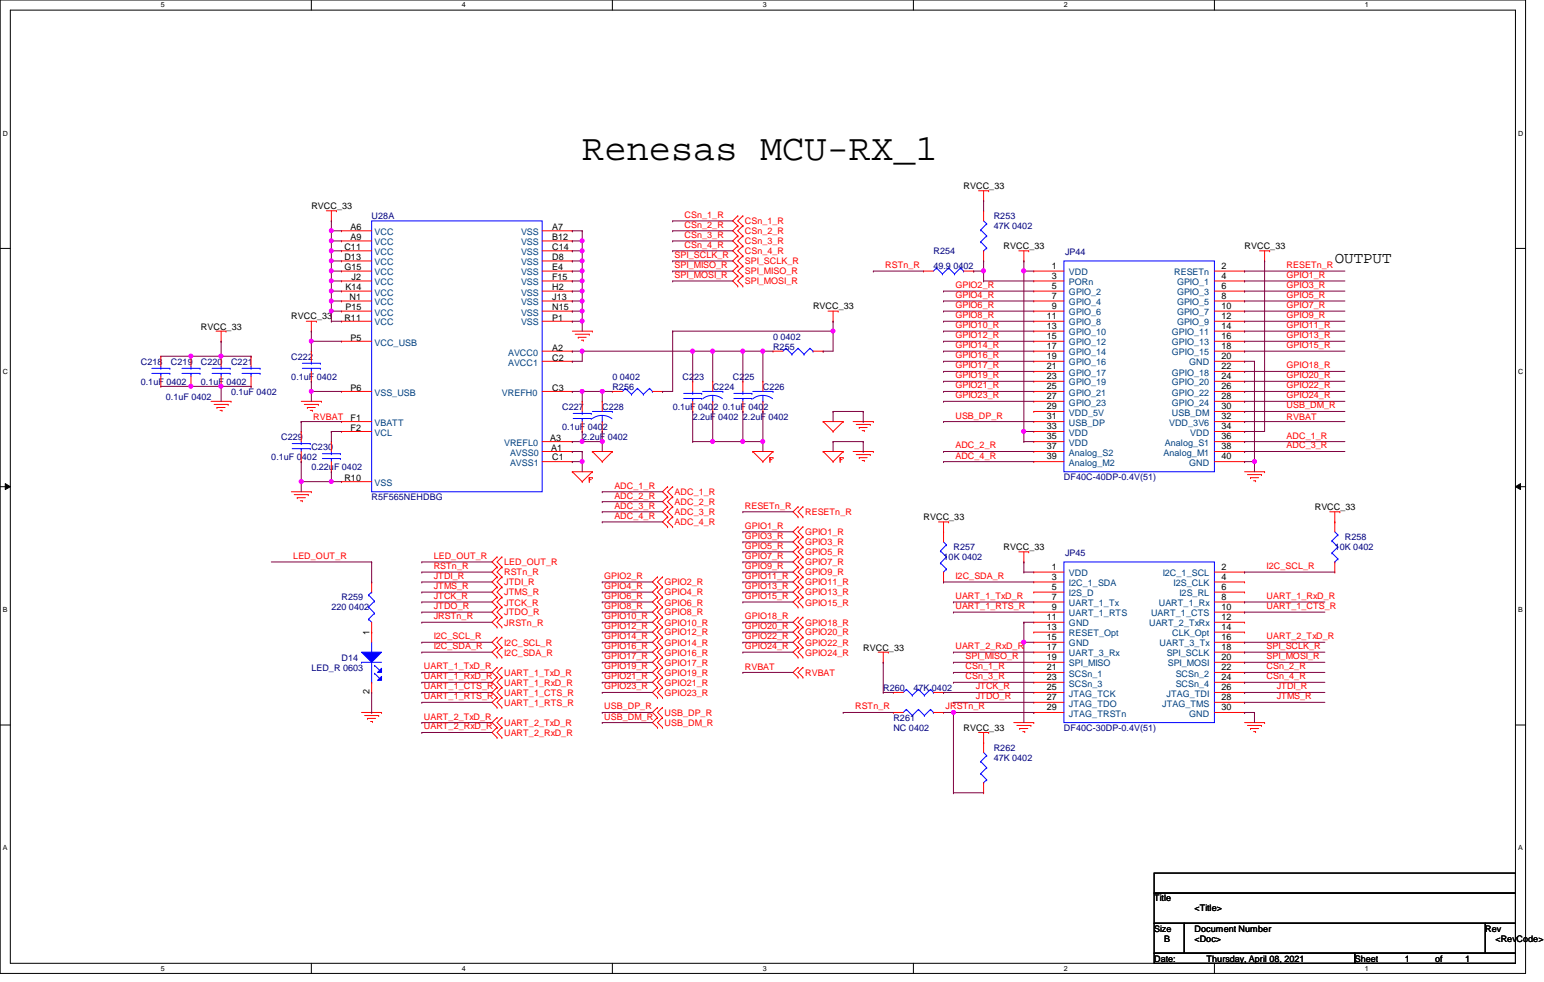
[picture p28: page 1]

# Renesas MCU-RX_2

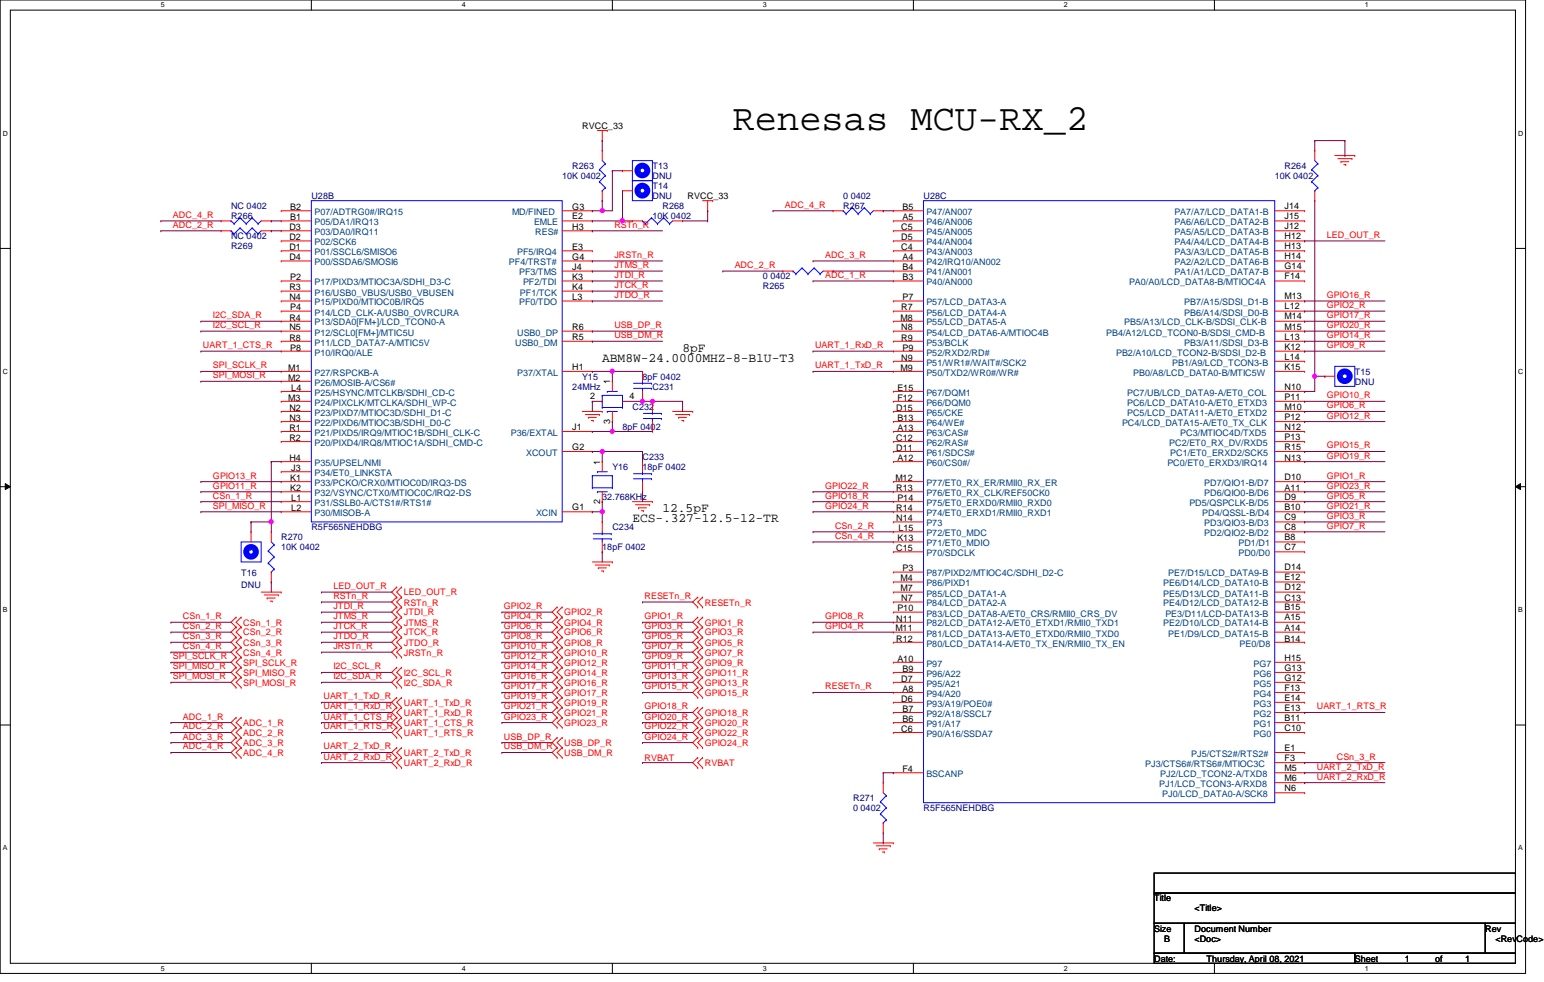
[picture p29: page 2]
