Macnica-Galaxy/Document/(list of files, drawings)

Other design files:
ADI ADXL362 Sensor/53 ADI ADXL362_SENSOR.DSN
Base board Schematic_C.DSN
Cypress PSOC6 MCU/23 CYPRESS_BLE_MCU.DSN
Dialog DA14531 RF/52 DIALOG DA14531M.DSN
Dialog DA16200 RF/51 DIALOG DA16200M.DSN
IDT HS3001 Sensor/31 IDT_HS300X_SENSOR.DSN
IDT ZMOD4401 Sensor/32 IDT_ZMOD4410_SENSOR.DSN
Infineon DPS365 Sensor/43 INFINEON PRESSURE TEMPTURE.DSN
Microchip SAML21G18B MCU/21 MICROCHIP_SAM21G18.DSN
Microchip WIFI 1510 RF/26 MICROCHIP_WIFI_1510.DSN
ON LV0104CS Sensor/49 ON LV0104CS LIGHT SENSOR.DSN
ON NCT375 Sensor/33 ON_NCT375_SENSOR.DSN
Renesas ISL29023 Sensor/49 RENESAS ISL29023_SENSOR.DSN
Renesas RA MCU/50 RENESAS_RA2A1_MCU.DSN
Renesas RX MCU/47 RENESAS RX MCU.DSN
USI BM22 RF/41 USI_BM22_RF.DSN
